qohwxv/Transformer/01_SOURCE_CODE_DAY_DU/immutable/board_candidate_pause_checkpoint/PAYLOAD_INVENTORY.txt

PAYLOAD_SHA256SUMS.txt 9361
artifacts/OUTPUT_SHA256SUMS 10071
artifacts/RUN_STATUS.txt 1326
artifacts/vit_system_wrapper.bit 7797814
artifacts/vit_system_wrapper.xsa 3855492
board/m8_v3_mode3_50mhz.identity 5263
board/tools/README.md 9257
board/tools/analyze_m8_capture.py 14602
board/tools/build_m8_genesys_fsbl.tcl 6184
board/tools/compare_m8_outputs.py 8145
board/tools/m8_board_identity.py 37742
board/tools/replay_m8_board.tcl 35183
board/tools/run_m8_board.sh 12286
board/tools/test_m8_board_tools.py 11984
metadata/00_verify_m8_development.sh 33153
metadata/BUNDLE_INFO.json 59642
metadata/M8_DEVELOPMENT_SHA256SUMS.txt 44326
metadata/PERF_PROFILE_ABI_V1_13.json 8312
model/hash_manifest.json 1136
model/post_encoder_step_32_logits_f32.hex 9000
model/post_encoder_step_33p_probabilities_f32.hex 9000
model/prepared_input.bin 602112
model/verification_report.json 232013
model/vit_model.bin 173685760
model/vit_model_table.bin 12928
model/vit_model_table.json 236235
model/vit_runtime_config.json 7854
receipt/FULL_VIVADO_RECEIPT_README.md 4794
receipt/FULL_VIVADO_RECEIPT_STATUS.json 4530
receipt/RECEIPT_MANIFEST.sha256 89
receipt/verify_receipt.sh 12317
reports/board_post_route_constraint_coverage_gate.rpt 4806
reports/board_post_route_drc_gate.rpt 57
reports/board_post_route_dsp.rpt 31
reports/board_post_route_m8_ram_mapping.rpt 364582
reports/board_post_route_methodology_gate.rpt 65
reports/board_post_route_route_gate.rpt 34
reports/board_post_route_timing_gate.rpt 31
reports/board_post_route_utilization.rpt 13127
reports/board_post_route_xsa_contents.rpt 515
simulation/interrupted_layer0_receipt/INTERRUPTION_METADATA.txt 1080
simulation/interrupted_layer0_receipt/MARKER_AUDIT.txt 189
simulation/interrupted_layer0_receipt/PAYLOAD_SHA256SUMS.txt 3930
simulation/interrupted_layer0_receipt/PROCESS_STATE_AT_CAPTURE.txt 154
simulation/interrupted_layer0_receipt/REMOTE_RESOURCE_STATE.txt 161
simulation/interrupted_layer0_receipt/SOURCE_INPUT_PATHS.txt 4410
simulation/interrupted_layer0_receipt/SOURCE_STATE_BEFORE_ORIGINAL.txt 1506
simulation/interrupted_layer0_receipt/SOURCE_STATE_CURRENT_SHA256SUMS.txt 11010
simulation/interrupted_layer0_receipt/SOURCE_STATE_CURRENT_SUMMARY.txt 217
simulation/interrupted_layer0_receipt/outer/m8-e02-layer0-reqfix-cb31a804-20260809T030500Z.outer.exit 2
simulation/interrupted_layer0_receipt/outer/m8-e02-layer0-reqfix-cb31a804-20260809T030500Z.outer.log 27338
simulation/interrupted_layer0_receipt/outer/m8-e02-layer0-reqfix-cb31a804-20260809T030500Z.outer.pid 8
simulation/interrupted_layer0_receipt/run/SOURCE_STATE_BEFORE.txt 1506
simulation/interrupted_layer0_receipt/run/build.log 21026
simulation/interrupted_layer0_receipt/run/layers/layer00/asset_stage.log 401
simulation/interrupted_layer0_receipt/run/layers/layer00/assets/asset_evidence.json 15621
simulation/interrupted_layer0_receipt/run/layers/layer00/assets/fc1_bias_f32.hex 27648
simulation/interrupted_layer0_receipt/run/layers/layer00/assets/fc1_weight_packed_fp16_u32.hex 10616832
simulation/interrupted_layer0_receipt/run/layers/layer00/assets/fc2_bias_f32.hex 6912
simulation/interrupted_layer0_receipt/run/layers/layer00/assets/fc2_weight_packed_fp16_u32.hex 10616832
simulation/interrupted_layer0_receipt/run/layers/layer00/assets/golden_t004_f32.hex 1361664
simulation/interrupted_layer0_receipt/run/layers/layer00/assets/input_t004_f32.hex 1361664
simulation/interrupted_layer0_receipt/run/layers/layer00/assets/k_bias_f32.hex 6912
simulation/interrupted_layer0_receipt/run/layers/layer00/assets/k_weight_packed_fp16_u32.hex 2654208
simulation/interrupted_layer0_receipt/run/layers/layer00/assets/ln1_beta_f32.hex 6912
simulation/interrupted_layer0_receipt/run/layers/layer00/assets/ln1_gamma_f32.hex 6912
simulation/interrupted_layer0_receipt/run/layers/layer00/assets/ln2_beta_f32.hex 6912
simulation/interrupted_layer0_receipt/run/layers/layer00/assets/ln2_gamma_f32.hex 6912
simulation/interrupted_layer0_receipt/run/layers/layer00/assets/o_bias_f32.hex 6912
simulation/interrupted_layer0_receipt/run/layers/layer00/assets/o_weight_packed_fp16_u32.hex 2654208
simulation/interrupted_layer0_receipt/run/layers/layer00/assets/q_bias_f32.hex 6912
simulation/interrupted_layer0_receipt/run/layers/layer00/assets/q_weight_packed_fp16_u32.hex 2654208
simulation/interrupted_layer0_receipt/run/layers/layer00/assets/v_bias_f32.hex 6912
simulation/interrupted_layer0_receipt/run/layers/layer00/assets/v_weight_packed_fp16_u32.hex 2654208
simulation/interrupted_layer0_receipt/run/layers/layer00/outputs/encoder_output_rtl_f32.hex 0
simulation/interrupted_layer0_receipt/run/layers/layer00/run.log 4094
simulation/interrupted_layer0_receipt/run/summary.log 27153
source/SOURCE_SNAPSHOT.tar.gz 140007
