qohwxv/Transformer/01_SOURCE_CODE_DAY_DU/immutable/full_vivado_receipt/remote_snapshot/reports/m8/server_runs/20260808T181104Z-m8-e01-mode3-threepass-receipt/TRANSFER_VERIFICATION.txt

REMOTE_TO_LOCAL_TRANSFER VERIFIED
evidence_class=VERIFIED
captured_utc=2026-08-08T18:14:38Z
method=rsync_archive_copy_then_checksum_itemized_dry_run
remote_host=192.168.4.85
remote_workspace=/home/s23520579/Vivado_project/vit_m8_db4e84bbe7b2_workspace
raw_run_20260808T172200Z_files=2 checksum_differences=0
raw_run_20260808T172400Z_files=20 checksum_differences=0
raw_run_20260808T173900Z_files=20 checksum_differences=0
raw_run_20260808T175400Z_files=20 checksum_differences=0
production_workspace_paths=80 checksum_differences=0
explicit_workspace_input_paths=18 checksum_differences=0
workspace_snapshot_unique_files=98
rsync_checksum_dry_run_stdout_lines=0
current_runner_remote_sha256=0f376c03632d9fa5148b1939004d992ebecf4b88e71cd977ff0573b1c1ab98f6
current_runner_local_sha256=0f376c03632d9fa5148b1939004d992ebecf4b88e71cd977ff0573b1c1ab98f6
current_runner_remote_local_match=YES
historical_observation_runner_origin=/tmp/m8_e01_observation_runner_1a12cdc9.sh
historical_exact_repeat_runner_origin=/tmp/m8_e01_repeat_runner_5a4c39e5.sh
historical_runner_identity_binding=recorded_source_state_sha256_and_exact_local_sha256
remote_mutation=NONE
