qohwxv/Transformer/01_SOURCE_CODE_DAY_DU/immutable/full_vivado_receipt/remote_snapshot/reports/m8/server_runs/20260808T161943Z-m8-softmax-ooc-ab-holdfix/VERIFICATION_RESULT.txt

VERIFIED_UTC=2026-08-08T16:37:18Z
RESULT=PASS
STATUS=SAFE
REMOTE_RUN_FILES=38
REMOTE_LOCAL_RUN_HASH_SET_MATCH=PASS
REMOTE_INITIAL_FAILURE_FILES=31
REMOTE_LOCAL_INITIAL_FAILURE_HASH_SET_MATCH=PASS
PASS_INPUT_FILES=13
PASS_INPUT_SHA256_CHECK=PASS
SOURCE_IDENTITY_VERIFY=PASS
PARENT_TERMINAL_GATES=PASS
CANDIDATE_TERMINAL_GATES=PASS
PARENT_DSP48_DSP58=0
CANDIDATE_DSP48_DSP58=0
CANDIDATE_RAMB36E2=1
INITIAL_FAILURE_PAYLOAD_SHA256_CHECK=PASS
REMOTE_MUTATION=NONE
FULL_DESIGN_RESULT=UNVERIFIED
BOARD_RESULT=UNVERIFIED
