qohwxv/Transformer/01_SOURCE_CODE_DAY_DU/immutable/full_vivado_receipt/remote_snapshot/reports/m8/server_runs/20260808T171800Z-m8-xsim-exact-10of10-receipt/TRANSFER_VERIFICATION.txt

Date: 2026-08-08 UTC
Method: rsync checksum-only dry-run after local copy; server side read-only
REMOTE_LOCAL_CHECKSUM_PARITY_PASS raw_runs=6 production_sources=80 xsim_inputs=11

The six remote run directories produced no checksum, size, path, or deletion
difference. The 80 production sources and all 11 filelist/runner/test/model
input paths also produced no checksum difference.
