qohwxv/Transformer/ILSVRC2012_dataset_test/inference_results_1000.csv

Image_Index | Image_Name | Expected_Class_ID | Expected_Class_Name | Predicted_Class_ID | Predicted_Class_Name | Top1_Match | Top5_Match | Latency_ms
1 | ILSVRC2012_val_00000001.JPEG | 65 | sea_snake | 65 | sea_snake | True | True | 168.02
2 | ILSVRC2012_val_00000002.JPEG | 970 | alp | 795 | ski | False | True | 172.57
3 | ILSVRC2012_val_00000003.JPEG | 230 | Shetland_sheepdog | 230 | Shetland_sheepdog | True | True | 180.33
4 | ILSVRC2012_val_00000004.JPEG | 809 | soup_bowl | 809 | soup_bowl | True | True | 178.37
5 | ILSVRC2012_val_00000005.JPEG | 516 | cradle | 520 | crib | False | True | 177.13
6 | ILSVRC2012_val_00000006.JPEG | 57 | garter_snake | 60 | night_snake | False | True | 187.81
7 | ILSVRC2012_val_00000007.JPEG | 334 | porcupine | 334 | porcupine | True | True | 175.34
8 | ILSVRC2012_val_00000008.JPEG | 415 | bakery | 415 | bakery | True | True | 183.46
9 | ILSVRC2012_val_00000009.JPEG | 674 | mousetrap | 674 | mousetrap | True | True | 175.79
10 | ILSVRC2012_val_00000010.JPEG | 332 | Angora | 332 | Angora | True | True | 179.12
11 | ILSVRC2012_val_00000011.JPEG | 109 | brain_coral | 109 | brain_coral | True | True | 177.51
12 | ILSVRC2012_val_00000012.JPEG | 286 | cougar | 286 | cougar | True | True | 175.57
13 | ILSVRC2012_val_00000013.JPEG | 370 | guenon | 370 | guenon | True | True | 179.91
14 | ILSVRC2012_val_00000014.JPEG | 757 | recreational_vehicle | 757 | recreational_vehicle | True | True | 180.74
15 | ILSVRC2012_val_00000015.JPEG | 595 | harvester | 595 | harvester | True | True | 179.40
16 | ILSVRC2012_val_00000016.JPEG | 147 | grey_whale | 147 | grey_whale | True | True | 178.61
17 | ILSVRC2012_val_00000017.JPEG | 108 | sea_anemone | 108 | sea_anemone | True | True | 177.63
18 | ILSVRC2012_val_00000018.JPEG | 23 | vulture | 23 | vulture | True | True | 180.18
19 | ILSVRC2012_val_00000019.JPEG | 478 | carton | 478 | carton | True | True | 184.34
20 | ILSVRC2012_val_00000020.JPEG | 517 | crane | 517 | crane | True | True | 179.89
21 | ILSVRC2012_val_00000021.JPEG | 334 | porcupine | 334 | porcupine | True | True | 183.48
22 | ILSVRC2012_val_00000022.JPEG | 173 | Ibizan_hound | 238 | Greater_Swiss_Mountain_dog | False | True | 184.89
23 | ILSVRC2012_val_00000023.JPEG | 948 | Granny_Smith | 948 | Granny_Smith | True | True | 180.93
24 | ILSVRC2012_val_00000024.JPEG | 727 | planetarium | 727 | planetarium | True | True | 183.33
25 | ILSVRC2012_val_00000025.JPEG | 23 | vulture | 23 | vulture | True | True | 186.89
26 | ILSVRC2012_val_00000026.JPEG | 846 | table_lamp | 846 | table_lamp | True | True | 186.26
27 | ILSVRC2012_val_00000027.JPEG | 270 | white_wolf | 270 | white_wolf | True | True | 186.30
28 | ILSVRC2012_val_00000028.JPEG | 167 | English_foxhound | 166 | Walker_hound | False | True | 186.32
29 | ILSVRC2012_val_00000029.JPEG | 55 | green_snake | 55 | green_snake | True | True | 184.97
30 | ILSVRC2012_val_00000030.JPEG | 858 | tile_roof | 858 | tile_roof | True | True | 186.02
31 | ILSVRC2012_val_00000031.JPEG | 324 | cabbage_butterfly | 324 | cabbage_butterfly | True | True | 188.98
32 | ILSVRC2012_val_00000032.JPEG | 573 | go-kart | 573 | go-kart | True | True | 189.54
33 | ILSVRC2012_val_00000033.JPEG | 150 | sea_lion | 150 | sea_lion | True | True | 187.31
34 | ILSVRC2012_val_00000034.JPEG | 981 | ballplayer | 981 | ballplayer | True | True | 190.82
35 | ILSVRC2012_val_00000035.JPEG | 586 | half_track | 586 | half_track | True | True | 191.71
36 | ILSVRC2012_val_00000036.JPEG | 887 | vestment | 887 | vestment | True | True | 197.50
37 | ILSVRC2012_val_00000037.JPEG | 32 | tailed_frog | 26 | common_newt | False | True | 192.38
38 | ILSVRC2012_val_00000038.JPEG | 398 | abacus | 398 | abacus | True | True | 192.54
39 | ILSVRC2012_val_00000039.JPEG | 777 | scabbard | 777 | scabbard | True | True | 195.36
40 | ILSVRC2012_val_00000040.JPEG | 74 | garden_spider | 74 | garden_spider | True | True | 191.98
41 | ILSVRC2012_val_00000041.JPEG | 516 | cradle | 431 | bassinet | False | True | 194.61
42 | ILSVRC2012_val_00000042.JPEG | 756 | rain_barrel | 756 | rain_barrel | True | True | 192.22
43 | ILSVRC2012_val_00000043.JPEG | 129 | spoonbill | 129 | spoonbill | True | True | 193.32
44 | ILSVRC2012_val_00000044.JPEG | 198 | standard_schnauzer | 198 | standard_schnauzer | True | True | 194.34
45 | ILSVRC2012_val_00000045.JPEG | 256 | Newfoundland | 256 | Newfoundland | True | True | 197.36
46 | ILSVRC2012_val_00000046.JPEG | 725 | pitcher | 725 | pitcher | True | True | 199.48
47 | ILSVRC2012_val_00000047.JPEG | 565 | freight_car | 565 | freight_car | True | True | 196.48
48 | ILSVRC2012_val_00000048.JPEG | 167 | English_foxhound | 166 | Walker_hound | False | True | 212.59
49 | ILSVRC2012_val_00000049.JPEG | 717 | pickup | 717 | pickup | True | True | 195.08
50 | ILSVRC2012_val_00000050.JPEG | 394 | sturgeon | 390 | eel | False | True | 200.02
51 | ILSVRC2012_val_00000051.JPEG | 92 | bee_eater | 92 | bee_eater | True | True | 198.01
52 | ILSVRC2012_val_00000052.JPEG | 29 | axolotl | 29 | axolotl | True | True | 198.98
53 | ILSVRC2012_val_00000053.JPEG | 844 | switch | 844 | switch | True | True | 199.04
54 | ILSVRC2012_val_00000054.JPEG | 591 | handkerchief | 591 | handkerchief | True | True | 208.43
55 | ILSVRC2012_val_00000055.JPEG | 358 | polecat | 358 | polecat | True | True | 204.65
56 | ILSVRC2012_val_00000056.JPEG | 468 | cab | 468 | cab | True | True | 219.43
57 | ILSVRC2012_val_00000057.JPEG | 259 | Pomeranian | 154 | Pekinese | False | True | 200.42
58 | ILSVRC2012_val_00000058.JPEG | 994 | stinkhorn | 994 | stinkhorn | True | True | 199.72
59 | ILSVRC2012_val_00000059.JPEG | 872 | tripod | 872 | tripod | True | True | 207.60
60 | ILSVRC2012_val_00000060.JPEG | 588 | hamper | 588 | hamper | True | True | 208.63
61 | ILSVRC2012_val_00000061.JPEG | 474 | cardigan | 474 | cardigan | True | True | 198.53
62 | ILSVRC2012_val_00000062.JPEG | 183 | Kerry_blue_terrier | 183 | Kerry_blue_terrier | True | True | 209.75
63 | ILSVRC2012_val_00000063.JPEG | 107 | jellyfish | 107 | jellyfish | True | True | 206.20
64 | ILSVRC2012_val_00000064.JPEG | 46 | green_lizard | 46 | green_lizard | True | True | 219.48
65 | ILSVRC2012_val_00000065.JPEG | 842 | swimming_trunks | 842 | swimming_trunks | True | True | 203.56
66 | ILSVRC2012_val_00000066.JPEG | 390 | eel | 390 | eel | True | True | 201.03
67 | ILSVRC2012_val_00000067.JPEG | 101 | tusker | 101 | tusker | True | True | 201.14
68 | ILSVRC2012_val_00000068.JPEG | 887 | vestment | 887 | vestment | True | True | 201.45
69 | ILSVRC2012_val_00000069.JPEG | 870 | tricycle | 870 | tricycle | True | True | 204.33
70 | ILSVRC2012_val_00000070.JPEG | 841 | sweatshirt | 735 | poncho | False | True | 201.50
71 | ILSVRC2012_val_00000071.JPEG | 467 | butcher_shop | 467 | butcher_shop | True | True | 203.68
72 | ILSVRC2012_val_00000072.JPEG | 149 | dugong | 149 | dugong | True | True | 203.51
73 | ILSVRC2012_val_00000073.JPEG | 21 | kite | 21 | kite | True | True | 206.24
74 | ILSVRC2012_val_00000074.JPEG | 476 | carousel | 476 | carousel | True | True | 207.01
75 | ILSVRC2012_val_00000075.JPEG | 80 | black_grouse | 80 | black_grouse | True | True | 208.38
76 | ILSVRC2012_val_00000076.JPEG | 424 | barbershop | 424 | barbershop | True | True | 210.12
77 | ILSVRC2012_val_00000077.JPEG | 159 | Rhodesian_ridgeback | 159 | Rhodesian_ridgeback | True | True | 208.42
78 | ILSVRC2012_val_00000078.JPEG | 275 | African_hunting_dog | 275 | African_hunting_dog | True | True | 323.65
79 | ILSVRC2012_val_00000079.JPEG | 175 | otterhound | 175 | otterhound | True | True | 289.63
80 | ILSVRC2012_val_00000080.JPEG | 461 | breastplate | 461 | breastplate | True | True | 303.09
81 | ILSVRC2012_val_00000081.JPEG | 970 | alp | 970 | alp | True | True | 290.02
82 | ILSVRC2012_val_00000082.JPEG | 160 | Afghan_hound | 160 | Afghan_hound | True | True | 316.87
83 | ILSVRC2012_val_00000083.JPEG | 788 | shoe_shop | 788 | shoe_shop | True | True | 302.03
84 | ILSVRC2012_val_00000084.JPEG | 58 | water_snake | 58 | water_snake | True | True | 466.79
85 | ILSVRC2012_val_00000085.JPEG | 479 | car_wheel | 479 | car_wheel | True | True | 293.99
86 | ILSVRC2012_val_00000086.JPEG | 498 | cinema | 498 | cinema | True | True | 325.22
87 | ILSVRC2012_val_00000087.JPEG | 369 | siamang | 380 | titi | False | False | 302.28
88 | ILSVRC2012_val_00000088.JPEG | 28 | spotted_salamander | 28 | spotted_salamander | True | True | 291.68
89 | ILSVRC2012_val_00000089.JPEG | 487 | cellular_telephone | 487 | cellular_telephone | True | True | 299.86
90 | ILSVRC2012_val_00000090.JPEG | 50 | American_alligator | 50 | American_alligator | True | True | 276.13
91 | ILSVRC2012_val_00000091.JPEG | 270 | white_wolf | 270 | white_wolf | True | True | 284.87
92 | ILSVRC2012_val_00000092.JPEG | 383 | Madagascar_cat | 384 | indri | False | True | 273.91
93 | ILSVRC2012_val_00000093.JPEG | 366 | gorilla | 366 | gorilla | True | True | 283.38
94 | ILSVRC2012_val_00000094.JPEG | 780 | schooner | 484 | catamaran | False | True | 277.42
95 | ILSVRC2012_val_00000095.JPEG | 373 | macaque | 373 | macaque | True | True | 280.81
96 | ILSVRC2012_val_00000096.JPEG | 705 | passenger_car | 705 | passenger_car | True | True | 290.85
97 | ILSVRC2012_val_00000097.JPEG | 330 | wood_rabbit | 330 | wood_rabbit | True | True | 275.35
98 | ILSVRC2012_val_00000098.JPEG | 142 | dowitcher | 142 | dowitcher | True | True | 293.35
99 | ILSVRC2012_val_00000099.JPEG | 949 | strawberry | 949 | strawberry | True | True | 276.21
100 | ILSVRC2012_val_00000100.JPEG | 349 | bighorn | 349 | bighorn | True | True | 295.62
101 | ILSVRC2012_val_00000101.JPEG | 473 | can_opener | 473 | can_opener | True | True | 311.46
102 | ILSVRC2012_val_00000102.JPEG | 159 | Rhodesian_ridgeback | 159 | Rhodesian_ridgeback | True | True | 286.40
103 | ILSVRC2012_val_00000103.JPEG | 872 | tripod | 872 | tripod | True | True | 284.87
104 | ILSVRC2012_val_00000104.JPEG | 878 | typewriter_keyboard | 878 | typewriter_keyboard | True | True | 304.32
105 | ILSVRC2012_val_00000105.JPEG | 201 | silky_terrier | 201 | silky_terrier | True | True | 291.46
106 | ILSVRC2012_val_00000106.JPEG | 906 | Windsor_tie | 906 | Windsor_tie | True | True | 296.83
107 | ILSVRC2012_val_00000107.JPEG | 70 | harvestman | 70 | harvestman | True | True | 307.57
108 | ILSVRC2012_val_00000108.JPEG | 486 | cello | 486 | cello | True | True | 290.98
109 | ILSVRC2012_val_00000109.JPEG | 632 | loudspeaker | 632 | loudspeaker | True | True | 283.17
110 | ILSVRC2012_val_00000110.JPEG | 608 | jean | 608 | jean | True | True | 295.29
111 | ILSVRC2012_val_00000111.JPEG | 122 | American_lobster | 122 | American_lobster | True | True | 280.11
112 | ILSVRC2012_val_00000112.JPEG | 720 | pill_bottle | 720 | pill_bottle | True | True | 285.08
113 | ILSVRC2012_val_00000113.JPEG | 227 | kelpie | 227 | kelpie | True | True | 468.55
114 | ILSVRC2012_val_00000114.JPEG | 686 | oil_filter | 686 | oil_filter | True | True | 294.99
115 | ILSVRC2012_val_00000115.JPEG | 173 | Ibizan_hound | 173 | Ibizan_hound | True | True | 294.19
116 | ILSVRC2012_val_00000116.JPEG | 959 | carbonara | 959 | carbonara | True | True | 297.62
117 | ILSVRC2012_val_00000117.JPEG | 638 | maillot | 638 | maillot | True | True | 299.03
118 | ILSVRC2012_val_00000118.JPEG | 646 | maze | 646 | maze | True | True | 296.31
119 | ILSVRC2012_val_00000119.JPEG | 664 | monitor | 598 | home_theater | False | True | 292.40
120 | ILSVRC2012_val_00000120.JPEG | 645 | maypole | 645 | maypole | True | True | 280.58
121 | ILSVRC2012_val_00000121.JPEG | 718 | pier | 449 | boathouse | False | True | 284.04
122 | ILSVRC2012_val_00000122.JPEG | 483 | castle | 483 | castle | True | True | 281.40
123 | ILSVRC2012_val_00000123.JPEG | 852 | tennis_ball | 852 | tennis_ball | True | True | 292.31
124 | ILSVRC2012_val_00000124.JPEG | 392 | rock_beauty | 397 | puffer | False | True | 301.02
125 | ILSVRC2012_val_00000125.JPEG | 311 | grasshopper | 311 | grasshopper | True | True | 295.98
126 | ILSVRC2012_val_00000126.JPEG | 457 | bow_tie | 457 | bow_tie | True | True | 308.27
127 | ILSVRC2012_val_00000127.JPEG | 352 | impala | 352 | impala | True | True | 286.46
128 | ILSVRC2012_val_00000128.JPEG | 22 | bald_eagle | 21 | kite | False | True | 292.79
129 | ILSVRC2012_val_00000129.JPEG | 934 | hotdog | 934 | hotdog | True | True | 294.44
130 | ILSVRC2012_val_00000130.JPEG | 283 | Persian_cat | 283 | Persian_cat | True | True | 296.67
131 | ILSVRC2012_val_00000131.JPEG | 802 | snowmobile | 802 | snowmobile | True | True | 299.29
132 | ILSVRC2012_val_00000132.JPEG | 553 | file | 553 | file | True | True | 288.17
133 | ILSVRC2012_val_00000133.JPEG | 276 | hyena | 276 | hyena | True | True | 289.05
134 | ILSVRC2012_val_00000134.JPEG | 236 | Doberman | 234 | Rottweiler | False | True | 297.74
135 | ILSVRC2012_val_00000135.JPEG | 751 | racer | 751 | racer | True | True | 293.88
136 | ILSVRC2012_val_00000136.JPEG | 343 | warthog | 342 | wild_boar | False | True | 312.21
137 | ILSVRC2012_val_00000137.JPEG | 528 | dial_telephone | 613 | joystick | False | True | 308.98
138 | ILSVRC2012_val_00000138.JPEG | 328 | sea_urchin | 328 | sea_urchin | True | True | 323.99
139 | ILSVRC2012_val_00000139.JPEG | 969 | eggnog | 969 | eggnog | True | True | 297.70
140 | ILSVRC2012_val_00000140.JPEG | 558 | flute | 251 | dalmatian | False | True | 296.63
141 | ILSVRC2012_val_00000141.JPEG | 163 | bloodhound | 163 | bloodhound | True | True | 461.22
142 | ILSVRC2012_val_00000142.JPEG | 328 | sea_urchin | 328 | sea_urchin | True | True | 281.46
143 | ILSVRC2012_val_00000143.JPEG | 771 | safe | 771 | safe | True | True | 307.61
144 | ILSVRC2012_val_00000144.JPEG | 726 | plane | 726 | plane | True | True | 350.83
145 | ILSVRC2012_val_00000145.JPEG | 977 | sandbar | 977 | sandbar | True | True | 356.79
146 | ILSVRC2012_val_00000146.JPEG | 875 | trombone | 513 | cornet | False | True | 326.49
147 | ILSVRC2012_val_00000147.JPEG | 265 | toy_poodle | 266 | miniature_poodle | False | True | 316.63
148 | ILSVRC2012_val_00000148.JPEG | 686 | oil_filter | 686 | oil_filter | True | True | 297.86
149 | ILSVRC2012_val_00000149.JPEG | 590 | hand-held_computer | 590 | hand-held_computer | True | True | 291.74
150 | ILSVRC2012_val_00000150.JPEG | 975 | lakeside | 978 | seashore | False | True | 288.61
151 | ILSVRC2012_val_00000151.JPEG | 620 | laptop | 681 | notebook | False | True | 300.67
152 | ILSVRC2012_val_00000152.JPEG | 637 | mailbox | 637 | mailbox | True | True | 348.50
153 | ILSVRC2012_val_00000153.JPEG | 39 | common_iguana | 39 | common_iguana | True | True | 324.04
154 | ILSVRC2012_val_00000154.JPEG | 115 | sea_slug | 115 | sea_slug | True | True | 307.85
155 | ILSVRC2012_val_00000155.JPEG | 937 | broccoli | 937 | broccoli | True | True | 305.63
156 | ILSVRC2012_val_00000156.JPEG | 272 | coyote | 274 | dhole | False | False | 297.22
157 | ILSVRC2012_val_00000157.JPEG | 277 | red_fox | 277 | red_fox | True | True | 300.02
158 | ILSVRC2012_val_00000158.JPEG | 763 | revolver | 763 | revolver | True | True | 291.24
159 | ILSVRC2012_val_00000159.JPEG | 789 | shoji | 532 | dining_table | False | False | 303.44
160 | ILSVRC2012_val_00000160.JPEG | 646 | maze | 646 | maze | True | True | 300.07
161 | ILSVRC2012_val_00000161.JPEG | 213 | Irish_setter | 168 | redbone | False | True | 308.29
162 | ILSVRC2012_val_00000162.JPEG | 493 | chiffonier | 894 | wardrobe | False | True | 293.06
163 | ILSVRC2012_val_00000163.JPEG | 647 | measuring_cup | 647 | measuring_cup | True | True | 301.24
164 | ILSVRC2012_val_00000164.JPEG | 504 | coffee_mug | 504 | coffee_mug | True | True | 290.82
165 | ILSVRC2012_val_00000165.JPEG | 937 | broccoli | 937 | broccoli | True | True | 293.86
166 | ILSVRC2012_val_00000166.JPEG | 687 | organ | 687 | organ | True | True | 296.03
167 | ILSVRC2012_val_00000167.JPEG | 781 | scoreboard | 781 | scoreboard | True | True | 298.79
168 | ILSVRC2012_val_00000168.JPEG | 666 | mortar | 666 | mortar | True | True | 289.75
169 | ILSVRC2012_val_00000169.JPEG | 583 | guillotine | 583 | guillotine | True | True | 551.03
170 | ILSVRC2012_val_00000170.JPEG | 158 | toy_terrier | 158 | toy_terrier | True | True | 291.05
171 | ILSVRC2012_val_00000171.JPEG | 825 | stone_wall | 825 | stone_wall | True | True | 302.07
172 | ILSVRC2012_val_00000172.JPEG | 212 | English_setter | 212 | English_setter | True | True | 294.71
173 | ILSVRC2012_val_00000173.JPEG | 659 | mixing_bowl | 659 | mixing_bowl | True | True | 308.45
174 | ILSVRC2012_val_00000174.JPEG | 257 | Great_Pyrenees | 257 | Great_Pyrenees | True | True | 290.27
175 | ILSVRC2012_val_00000175.JPEG | 436 | beach_wagon | 436 | beach_wagon | True | True | 296.10
176 | ILSVRC2012_val_00000176.JPEG | 196 | miniature_schnauzer | 199 | Scotch_terrier | False | False | 299.29
177 | ILSVRC2012_val_00000177.JPEG | 140 | red-backed_sandpiper | 140 | red-backed_sandpiper | True | True | 288.79
178 | ILSVRC2012_val_00000178.JPEG | 248 | Eskimo_dog | 250 | Siberian_husky | False | True | 288.29
179 | ILSVRC2012_val_00000179.JPEG | 339 | sorrel | 339 | sorrel | True | True | 305.88
180 | ILSVRC2012_val_00000180.JPEG | 230 | Shetland_sheepdog | 230 | Shetland_sheepdog | True | True | 300.46
181 | ILSVRC2012_val_00000181.JPEG | 361 | skunk | 361 | skunk | True | True | 301.69
182 | ILSVRC2012_val_00000182.JPEG | 544 | Dutch_oven | 926 | hot_pot | False | True | 291.33
183 | ILSVRC2012_val_00000183.JPEG | 935 | mashed_potato | 935 | mashed_potato | True | True | 297.35
184 | ILSVRC2012_val_00000184.JPEG | 638 | maillot | 445 | bikini | False | True | 302.76
185 | ILSVRC2012_val_00000185.JPEG | 627 | limousine | 656 | minivan | False | True | 311.87
186 | ILSVRC2012_val_00000186.JPEG | 289 | snow_leopard | 289 | snow_leopard | True | True | 291.01
187 | ILSVRC2012_val_00000187.JPEG | 867 | trailer_truck | 867 | trailer_truck | True | True | 308.62
188 | ILSVRC2012_val_00000188.JPEG | 272 | coyote | 272 | coyote | True | True | 323.87
189 | ILSVRC2012_val_00000189.JPEG | 103 | platypus | 103 | platypus | True | True | 306.39
190 | ILSVRC2012_val_00000190.JPEG | 584 | hair_slide | 584 | hair_slide | True | True | 286.59
191 | ILSVRC2012_val_00000191.JPEG | 180 | American_Staffordshire_terrier | 180 | American_Staffordshire_terrier | True | True | 286.32
192 | ILSVRC2012_val_00000192.JPEG | 703 | park_bench | 703 | park_bench | True | True | 304.33
193 | ILSVRC2012_val_00000193.JPEG | 449 | boathouse | 449 | boathouse | True | True | 300.70
194 | ILSVRC2012_val_00000194.JPEG | 771 | safe | 771 | safe | True | True | 294.75
195 | ILSVRC2012_val_00000195.JPEG | 118 | Dungeness_crab | 118 | Dungeness_crab | True | True | 291.36
196 | ILSVRC2012_val_00000196.JPEG | 396 | lionfish | 396 | lionfish | True | True | 298.92
197 | ILSVRC2012_val_00000197.JPEG | 934 | hotdog | 934 | hotdog | True | True | 297.60
198 | ILSVRC2012_val_00000198.JPEG | 16 | bulbul | 16 | bulbul | True | True | 293.60
199 | ILSVRC2012_val_00000199.JPEG | 548 | entertainment_center | 548 | entertainment_center | True | True | 468.65
200 | ILSVRC2012_val_00000200.JPEG | 993 | gyromitra | 993 | gyromitra | True | True | 307.67
201 | ILSVRC2012_val_00000201.JPEG | 704 | parking_meter | 704 | parking_meter | True | True | 324.30
202 | ILSVRC2012_val_00000202.JPEG | 457 | bow_tie | 452 | bonnet | False | True | 295.08
203 | ILSVRC2012_val_00000203.JPEG | 233 | Bouvier_des_Flandres | 233 | Bouvier_des_Flandres | True | True | 307.33
204 | ILSVRC2012_val_00000204.JPEG | 401 | accordion | 642 | marimba | False | True | 295.06
205 | ILSVRC2012_val_00000205.JPEG | 827 | stove | 827 | stove | True | True | 303.22
206 | ILSVRC2012_val_00000206.JPEG | 376 | proboscis_monkey | 376 | proboscis_monkey | True | True | 292.12
207 | ILSVRC2012_val_00000207.JPEG | 146 | albatross | 146 | albatross | True | True | 293.95
208 | ILSVRC2012_val_00000208.JPEG | 606 | iron | 606 | iron | True | True | 311.58
209 | ILSVRC2012_val_00000209.JPEG | 922 | menu | 922 | menu | True | True | 318.45
210 | ILSVRC2012_val_00000210.JPEG | 516 | cradle | 431 | bassinet | False | True | 305.91
211 | ILSVRC2012_val_00000211.JPEG | 284 | Siamese_cat | 284 | Siamese_cat | True | True | 300.60
212 | ILSVRC2012_val_00000212.JPEG | 889 | violin | 889 | violin | True | True | 289.23
213 | ILSVRC2012_val_00000213.JPEG | 475 | car_mirror | 475 | car_mirror | True | True | 306.77
214 | ILSVRC2012_val_00000214.JPEG | 978 | seashore | 978 | seashore | True | True | 286.33
215 | ILSVRC2012_val_00000215.JPEG | 475 | car_mirror | 475 | car_mirror | True | True | 295.41
216 | ILSVRC2012_val_00000216.JPEG | 984 | rapeseed | 984 | rapeseed | True | True | 300.17
217 | ILSVRC2012_val_00000217.JPEG | 16 | bulbul | 16 | bulbul | True | True | 303.74
218 | ILSVRC2012_val_00000218.JPEG | 77 | wolf_spider | 77 | wolf_spider | True | True | 296.49
219 | ILSVRC2012_val_00000219.JPEG | 610 | jersey | 610 | jersey | True | True | 310.54
220 | ILSVRC2012_val_00000220.JPEG | 254 | pug | 254 | pug | True | True | 314.65
221 | ILSVRC2012_val_00000221.JPEG | 636 | mailbag | 636 | mailbag | True | True | 295.73
222 | ILSVRC2012_val_00000222.JPEG | 662 | modem | 662 | modem | True | True | 288.69
223 | ILSVRC2012_val_00000223.JPEG | 473 | can_opener | 473 | can_opener | True | True | 314.24
224 | ILSVRC2012_val_00000224.JPEG | 213 | Irish_setter | 213 | Irish_setter | True | True | 306.52
225 | ILSVRC2012_val_00000225.JPEG | 25 | European_fire_salamander | 25 | European_fire_salamander | True | True | 302.59
226 | ILSVRC2012_val_00000226.JPEG | 463 | bucket | 463 | bucket | True | True | 297.15
227 | ILSVRC2012_val_00000227.JPEG | 215 | Brittany_spaniel | 215 | Brittany_spaniel | True | True | 296.19
228 | ILSVRC2012_val_00000228.JPEG | 173 | Ibizan_hound | 173 | Ibizan_hound | True | True | 288.66
229 | ILSVRC2012_val_00000229.JPEG | 35 | mud_turtle | 35 | mud_turtle | True | True | 466.17
230 | ILSVRC2012_val_00000230.JPEG | 741 | prayer_rug | 741 | prayer_rug | True | True | 337.70
231 | ILSVRC2012_val_00000231.JPEG | 125 | hermit_crab | 125 | hermit_crab | True | True | 352.10
232 | ILSVRC2012_val_00000232.JPEG | 787 | shield | 399 | abaya | False | False | 246.38
233 | ILSVRC2012_val_00000233.JPEG | 289 | snow_leopard | 289 | snow_leopard | True | True | 220.83
234 | ILSVRC2012_val_00000234.JPEG | 425 | barn | 425 | barn | True | True | 222.84
235 | ILSVRC2012_val_00000235.JPEG | 973 | coral_reef | 973 | coral_reef | True | True | 217.69
236 | ILSVRC2012_val_00000236.JPEG | 1 | goldfish | 1 | goldfish | True | True | 221.91
237 | ILSVRC2012_val_00000237.JPEG | 167 | English_foxhound | 167 | English_foxhound | True | True | 218.48
238 | ILSVRC2012_val_00000238.JPEG | 121 | king_crab | 121 | king_crab | True | True | 243.74
239 | ILSVRC2012_val_00000239.JPEG | 445 | bikini | 445 | bikini | True | True | 243.57
240 | ILSVRC2012_val_00000240.JPEG | 702 | parallel_bars | 422 | barbell | False | True | 269.98
241 | ILSVRC2012_val_00000241.JPEG | 532 | dining_table | 532 | dining_table | True | True | 390.84
242 | ILSVRC2012_val_00000242.JPEG | 366 | gorilla | 366 | gorilla | True | True | 298.88
243 | ILSVRC2012_val_00000243.JPEG | 678 | neck_brace | 678 | neck_brace | True | True | 300.37
244 | ILSVRC2012_val_00000244.JPEG | 764 | rifle | 764 | rifle | True | True | 327.95
245 | ILSVRC2012_val_00000245.JPEG | 125 | hermit_crab | 125 | hermit_crab | True | True | 313.03
246 | ILSVRC2012_val_00000246.JPEG | 349 | bighorn | 349 | bighorn | True | True | 294.67
247 | ILSVRC2012_val_00000247.JPEG | 13 | junco | 13 | junco | True | True | 292.37
248 | ILSVRC2012_val_00000248.JPEG | 179 | Staffordshire_bullterrier | 179 | Staffordshire_bullterrier | True | True | 294.01
249 | ILSVRC2012_val_00000249.JPEG | 522 | croquet_ball | 522 | croquet_ball | True | True | 299.72
250 | ILSVRC2012_val_00000250.JPEG | 493 | chiffonier | 894 | wardrobe | False | True | 299.28
251 | ILSVRC2012_val_00000251.JPEG | 989 | hip | 989 | hip | True | True | 295.52
252 | ILSVRC2012_val_00000252.JPEG | 720 | pill_bottle | 720 | pill_bottle | True | True | 297.34
253 | ILSVRC2012_val_00000253.JPEG | 438 | beaker | 438 | beaker | True | True | 292.58
254 | ILSVRC2012_val_00000254.JPEG | 660 | mobile_home | 660 | mobile_home | True | True | 295.42
255 | ILSVRC2012_val_00000255.JPEG | 983 | scuba_diver | 801 | snorkel | False | True | 294.42
256 | ILSVRC2012_val_00000256.JPEG | 533 | dishrag | 533 | dishrag | True | True | 303.93
257 | ILSVRC2012_val_00000257.JPEG | 487 | cellular_telephone | 487 | cellular_telephone | True | True | 294.28
258 | ILSVRC2012_val_00000258.JPEG | 27 | eft | 27 | eft | True | True | 298.84
259 | ILSVRC2012_val_00000259.JPEG | 644 | matchstick | 644 | matchstick | True | True | 299.71
260 | ILSVRC2012_val_00000260.JPEG | 750 | quilt | 750 | quilt | True | True | 300.43
261 | ILSVRC2012_val_00000261.JPEG | 865 | toyshop | 865 | toyshop | True | True | 299.19
262 | ILSVRC2012_val_00000262.JPEG | 1 | goldfish | 1 | goldfish | True | True | 297.76
263 | ILSVRC2012_val_00000263.JPEG | 176 | Saluki | 176 | Saluki | True | True | 305.12
264 | ILSVRC2012_val_00000264.JPEG | 694 | paddlewheel | 694 | paddlewheel | True | True | 308.80
265 | ILSVRC2012_val_00000265.JPEG | 695 | padlock | 695 | padlock | True | True | 305.70
266 | ILSVRC2012_val_00000266.JPEG | 798 | slide_rule | 798 | slide_rule | True | True | 293.57
267 | ILSVRC2012_val_00000267.JPEG | 925 | consomme | 925 | consomme | True | True | 319.85
268 | ILSVRC2012_val_00000268.JPEG | 413 | assault_rifle | 413 | assault_rifle | True | True | 440.77
269 | ILSVRC2012_val_00000269.JPEG | 250 | Siberian_husky | 270 | white_wolf | False | False | 307.24
270 | ILSVRC2012_val_00000270.JPEG | 970 | alp | 972 | cliff | False | True | 301.48
271 | ILSVRC2012_val_00000271.JPEG | 821 | steel_arch_bridge | 821 | steel_arch_bridge | True | True | 307.03
272 | ILSVRC2012_val_00000272.JPEG | 421 | bannister | 421 | bannister | True | True | 294.49
273 | ILSVRC2012_val_00000273.JPEG | 361 | skunk | 361 | skunk | True | True | 299.58
274 | ILSVRC2012_val_00000274.JPEG | 920 | traffic_light | 920 | traffic_light | True | True | 296.93
275 | ILSVRC2012_val_00000275.JPEG | 761 | remote_control | 761 | remote_control | True | True | 308.63
276 | ILSVRC2012_val_00000276.JPEG | 27 | eft | 27 | eft | True | True | 283.52
277 | ILSVRC2012_val_00000277.JPEG | 676 | muzzle | 464 | buckle | False | True | 291.34
278 | ILSVRC2012_val_00000278.JPEG | 92 | bee_eater | 92 | bee_eater | True | True | 296.79
279 | ILSVRC2012_val_00000279.JPEG | 194 | Dandie_Dinmont | 194 | Dandie_Dinmont | True | True | 295.94
280 | ILSVRC2012_val_00000280.JPEG | 897 | washer | 897 | washer | True | True | 295.34
281 | ILSVRC2012_val_00000281.JPEG | 612 | jinrikisha | 612 | jinrikisha | True | True | 297.95
282 | ILSVRC2012_val_00000282.JPEG | 610 | jersey | 918 | crossword_puzzle | False | True | 318.82
283 | ILSVRC2012_val_00000283.JPEG | 283 | Persian_cat | 283 | Persian_cat | True | True | 307.34
284 | ILSVRC2012_val_00000284.JPEG | 881 | upright | 881 | upright | True | True | 318.32
285 | ILSVRC2012_val_00000285.JPEG | 906 | Windsor_tie | 906 | Windsor_tie | True | True | 308.43
286 | ILSVRC2012_val_00000286.JPEG | 899 | water_jug | 899 | water_jug | True | True | 292.56
287 | ILSVRC2012_val_00000287.JPEG | 426 | barometer | 426 | barometer | True | True | 313.72
288 | ILSVRC2012_val_00000288.JPEG | 554 | fireboat | 554 | fireboat | True | True | 301.14
289 | ILSVRC2012_val_00000289.JPEG | 403 | aircraft_carrier | 403 | aircraft_carrier | True | True | 301.11
290 | ILSVRC2012_val_00000290.JPEG | 826 | stopwatch | 531 | digital_watch | False | True | 295.59
291 | ILSVRC2012_val_00000291.JPEG | 869 | trench_coat | 869 | trench_coat | True | True | 300.67
292 | ILSVRC2012_val_00000292.JPEG | 730 | plow | 856 | thresher | False | True | 302.10
293 | ILSVRC2012_val_00000293.JPEG | 0 | tench | 0 | tench | True | True | 298.29
294 | ILSVRC2012_val_00000294.JPEG | 866 | tractor | 866 | tractor | True | True | 295.87
295 | ILSVRC2012_val_00000295.JPEG | 580 | greenhouse | 580 | greenhouse | True | True | 296.27
296 | ILSVRC2012_val_00000296.JPEG | 888 | viaduct | 888 | viaduct | True | True | 305.20
297 | ILSVRC2012_val_00000297.JPEG | 43 | frilled_lizard | 43 | frilled_lizard | True | True | 507.18
298 | ILSVRC2012_val_00000298.JPEG | 64 | green_mamba | 64 | green_mamba | True | True | 292.58
299 | ILSVRC2012_val_00000299.JPEG | 69 | trilobite | 69 | trilobite | True | True | 306.17
300 | ILSVRC2012_val_00000300.JPEG | 176 | Saluki | 176 | Saluki | True | True | 307.20
301 | ILSVRC2012_val_00000301.JPEG | 329 | sea_cucumber | 65 | sea_snake | False | True | 289.16
302 | ILSVRC2012_val_00000302.JPEG | 469 | caldron | 469 | caldron | True | True | 294.66
303 | ILSVRC2012_val_00000303.JPEG | 292 | tiger | 288 | leopard | False | False | 302.49
304 | ILSVRC2012_val_00000304.JPEG | 991 | coral_fungus | 991 | coral_fungus | True | True | 314.51
305 | ILSVRC2012_val_00000305.JPEG | 591 | handkerchief | 591 | handkerchief | True | True | 281.27
306 | ILSVRC2012_val_00000306.JPEG | 346 | water_buffalo | 346 | water_buffalo | True | True | 298.18
307 | ILSVRC2012_val_00000307.JPEG | 1 | goldfish | 1 | goldfish | True | True | 294.63
308 | ILSVRC2012_val_00000308.JPEG | 607 | jack-o'-lantern | 607 | jack-o'-lantern | True | True | 298.23
309 | ILSVRC2012_val_00000309.JPEG | 934 | hotdog | 934 | hotdog | True | True | 302.74
310 | ILSVRC2012_val_00000310.JPEG | 784 | screwdriver | 828 | strainer | False | False | 290.62
311 | ILSVRC2012_val_00000311.JPEG | 572 | goblet | 572 | goblet | True | True | 302.18
312 | ILSVRC2012_val_00000312.JPEG | 389 | barracouta | 389 | barracouta | True | True | 303.41
313 | ILSVRC2012_val_00000313.JPEG | 979 | valley | 979 | valley | True | True | 293.29
314 | ILSVRC2012_val_00000314.JPEG | 654 | minibus | 656 | minivan | False | True | 299.15
315 | ILSVRC2012_val_00000315.JPEG | 420 | banjo | 420 | banjo | True | True | 290.91
316 | ILSVRC2012_val_00000316.JPEG | 390 | eel | 390 | eel | True | True | 296.39
317 | ILSVRC2012_val_00000317.JPEG | 702 | parallel_bars | 702 | parallel_bars | True | True | 299.65
318 | ILSVRC2012_val_00000318.JPEG | 24 | great_grey_owl | 24 | great_grey_owl | True | True | 312.94
319 | ILSVRC2012_val_00000319.JPEG | 102 | echidna | 102 | echidna | True | True | 319.20
320 | ILSVRC2012_val_00000320.JPEG | 949 | strawberry | 949 | strawberry | True | True | 382.47
321 | ILSVRC2012_val_00000321.JPEG | 508 | computer_keyboard | 508 | computer_keyboard | True | True | 382.52
322 | ILSVRC2012_val_00000322.JPEG | 361 | skunk | 361 | skunk | True | True | 240.84
323 | ILSVRC2012_val_00000323.JPEG | 280 | grey_fox | 280 | grey_fox | True | True | 213.86
324 | ILSVRC2012_val_00000324.JPEG | 65 | sea_snake | 65 | sea_snake | True | True | 212.97
325 | ILSVRC2012_val_00000325.JPEG | 777 | scabbard | 777 | scabbard | True | True | 212.88
326 | ILSVRC2012_val_00000326.JPEG | 359 | black-footed_ferret | 359 | black-footed_ferret | True | True | 217.90
327 | ILSVRC2012_val_00000327.JPEG | 165 | black-and-tan_coonhound | 234 | Rottweiler | False | True | 214.11
328 | ILSVRC2012_val_00000328.JPEG | 21 | kite | 21 | kite | True | True | 215.45
329 | ILSVRC2012_val_00000329.JPEG | 7 | cock | 7 | cock | True | True | 217.38
330 | ILSVRC2012_val_00000330.JPEG | 525 | dam | 525 | dam | True | True | 217.05
331 | ILSVRC2012_val_00000331.JPEG | 760 | refrigerator | 760 | refrigerator | True | True | 214.98
332 | ILSVRC2012_val_00000332.JPEG | 938 | cauliflower | 938 | cauliflower | True | True | 219.89
333 | ILSVRC2012_val_00000333.JPEG | 254 | pug | 254 | pug | True | True | 221.71
334 | ILSVRC2012_val_00000334.JPEG | 733 | pole | 840 | swab | False | True | 219.39
335 | ILSVRC2012_val_00000335.JPEG | 707 | pay-phone | 707 | pay-phone | True | True | 218.28
336 | ILSVRC2012_val_00000336.JPEG | 463 | bucket | 463 | bucket | True | True | 224.56
337 | ILSVRC2012_val_00000337.JPEG | 60 | night_snake | 62 | rock_python | False | True | 219.85
338 | ILSVRC2012_val_00000338.JPEG | 887 | vestment | 887 | vestment | True | True | 213.44
339 | ILSVRC2012_val_00000339.JPEG | 531 | digital_watch | 477 | carpenter's_kit | False | False | 216.13
340 | ILSVRC2012_val_00000340.JPEG | 380 | titi | 380 | titi | True | True | 227.52
341 | ILSVRC2012_val_00000341.JPEG | 982 | groom | 982 | groom | True | True | 224.21
342 | ILSVRC2012_val_00000342.JPEG | 305 | dung_beetle | 305 | dung_beetle | True | True | 212.41
343 | ILSVRC2012_val_00000343.JPEG | 355 | llama | 355 | llama | True | True | 215.60
344 | ILSVRC2012_val_00000344.JPEG | 503 | cocktail_shaker | 503 | cocktail_shaker | True | True | 222.09
345 | ILSVRC2012_val_00000345.JPEG | 818 | spotlight | 745 | projector | False | True | 221.68
346 | ILSVRC2012_val_00000346.JPEG | 495 | china_cabinet | 495 | china_cabinet | True | True | 216.82
347 | ILSVRC2012_val_00000347.JPEG | 472 | canoe | 472 | canoe | True | True | 216.37
348 | ILSVRC2012_val_00000348.JPEG | 293 | cheetah | 293 | cheetah | True | True | 212.22
349 | ILSVRC2012_val_00000349.JPEG | 816 | spindle | 816 | spindle | True | True | 212.77
350 | ILSVRC2012_val_00000350.JPEG | 195 | Boston_bull | 195 | Boston_bull | True | True | 213.83
351 | ILSVRC2012_val_00000351.JPEG | 904 | window_screen | 738 | pot | False | True | 212.48
352 | ILSVRC2012_val_00000352.JPEG | 475 | car_mirror | 475 | car_mirror | True | True | 217.23
353 | ILSVRC2012_val_00000353.JPEG | 481 | cassette | 481 | cassette | True | True | 210.53
354 | ILSVRC2012_val_00000354.JPEG | 431 | bassinet | 431 | bassinet | True | True | 213.89
355 | ILSVRC2012_val_00000355.JPEG | 260 | chow | 260 | chow | True | True | 211.96
356 | ILSVRC2012_val_00000356.JPEG | 130 | flamingo | 130 | flamingo | True | True | 216.52
357 | ILSVRC2012_val_00000357.JPEG | 627 | limousine | 627 | limousine | True | True | 214.17
358 | ILSVRC2012_val_00000358.JPEG | 460 | breakwater | 978 | seashore | False | True | 215.92
359 | ILSVRC2012_val_00000359.JPEG | 622 | lens_cap | 622 | lens_cap | True | True | 213.74
360 | ILSVRC2012_val_00000360.JPEG | 696 | paintbrush | 673 | mouse | False | False | 212.99
361 | ILSVRC2012_val_00000361.JPEG | 300 | tiger_beetle | 300 | tiger_beetle | True | True | 227.10
362 | ILSVRC2012_val_00000362.JPEG | 37 | box_turtle | 37 | box_turtle | True | True | 217.21
363 | ILSVRC2012_val_00000363.JPEG | 133 | bittern | 133 | bittern | True | True | 221.35
364 | ILSVRC2012_val_00000364.JPEG | 637 | mailbox | 637 | mailbox | True | True | 217.56
365 | ILSVRC2012_val_00000365.JPEG | 675 | moving_van | 867 | trailer_truck | False | True | 215.34
366 | ILSVRC2012_val_00000366.JPEG | 465 | bulletproof_vest | 465 | bulletproof_vest | True | True | 215.72
367 | ILSVRC2012_val_00000367.JPEG | 592 | hard_disc | 592 | hard_disc | True | True | 213.98
368 | ILSVRC2012_val_00000368.JPEG | 741 | prayer_rug | 741 | prayer_rug | True | True | 213.04
369 | ILSVRC2012_val_00000369.JPEG | 895 | warplane | 895 | warplane | True | True | 213.20
370 | ILSVRC2012_val_00000370.JPEG | 91 | coucal | 91 | coucal | True | True | 212.49
371 | ILSVRC2012_val_00000371.JPEG | 109 | brain_coral | 109 | brain_coral | True | True | 215.54
372 | ILSVRC2012_val_00000372.JPEG | 582 | grocery_store | 778 | scale | False | True | 217.33
373 | ILSVRC2012_val_00000373.JPEG | 694 | paddlewheel | 694 | paddlewheel | True | True | 211.15
374 | ILSVRC2012_val_00000374.JPEG | 546 | electric_guitar | 546 | electric_guitar | True | True | 213.01
375 | ILSVRC2012_val_00000375.JPEG | 208 | Labrador_retriever | 208 | Labrador_retriever | True | True | 215.53
376 | ILSVRC2012_val_00000376.JPEG | 488 | chain | 488 | chain | True | True | 212.19
377 | ILSVRC2012_val_00000377.JPEG | 786 | sewing_machine | 786 | sewing_machine | True | True | 213.64
378 | ILSVRC2012_val_00000378.JPEG | 959 | carbonara | 959 | carbonara | True | True | 212.02
379 | ILSVRC2012_val_00000379.JPEG | 192 | cairn | 192 | cairn | True | True | 216.43
380 | ILSVRC2012_val_00000380.JPEG | 834 | suit | 834 | suit | True | True | 214.97
381 | ILSVRC2012_val_00000381.JPEG | 879 | umbrella | 879 | umbrella | True | True | 215.93
382 | ILSVRC2012_val_00000382.JPEG | 649 | megalith | 649 | megalith | True | True | 212.72
383 | ILSVRC2012_val_00000383.JPEG | 228 | komondor | 228 | komondor | True | True | 212.11
384 | ILSVRC2012_val_00000384.JPEG | 621 | lawn_mower | 621 | lawn_mower | True | True | 217.69
385 | ILSVRC2012_val_00000385.JPEG | 630 | Loafer | 703 | park_bench | False | True | 213.20
386 | ILSVRC2012_val_00000386.JPEG | 107 | jellyfish | 107 | jellyfish | True | True | 213.15
387 | ILSVRC2012_val_00000387.JPEG | 598 | home_theater | 598 | home_theater | True | True | 218.56
388 | ILSVRC2012_val_00000388.JPEG | 420 | banjo | 420 | banjo | True | True | 213.32
389 | ILSVRC2012_val_00000389.JPEG | 134 | crane | 132 | American_egret | False | True | 212.20
390 | ILSVRC2012_val_00000390.JPEG | 133 | bittern | 133 | bittern | True | True | 215.47
391 | ILSVRC2012_val_00000391.JPEG | 185 | Norfolk_terrier | 185 | Norfolk_terrier | True | True | 214.51
392 | ILSVRC2012_val_00000392.JPEG | 471 | cannon | 471 | cannon | True | True | 213.52
393 | ILSVRC2012_val_00000393.JPEG | 230 | Shetland_sheepdog | 230 | Shetland_sheepdog | True | True | 212.77
394 | ILSVRC2012_val_00000394.JPEG | 974 | geyser | 974 | geyser | True | True | 213.36
395 | ILSVRC2012_val_00000395.JPEG | 74 | garden_spider | 74 | garden_spider | True | True | 213.44
396 | ILSVRC2012_val_00000396.JPEG | 76 | tarantula | 76 | tarantula | True | True | 215.71
397 | ILSVRC2012_val_00000397.JPEG | 852 | tennis_ball | 852 | tennis_ball | True | True | 216.36
398 | ILSVRC2012_val_00000398.JPEG | 383 | Madagascar_cat | 853 | thatch | False | True | 228.32
399 | ILSVRC2012_val_00000399.JPEG | 267 | standard_poodle | 267 | standard_poodle | True | True | 213.77
400 | ILSVRC2012_val_00000400.JPEG | 419 | Band_Aid | 929 | ice_lolly | False | True | 220.73
401 | ILSVRC2012_val_00000401.JPEG | 359 | black-footed_ferret | 359 | black-footed_ferret | True | True | 220.44
402 | ILSVRC2012_val_00000402.JPEG | 484 | catamaran | 871 | trimaran | False | True | 218.98
403 | ILSVRC2012_val_00000403.JPEG | 510 | container_ship | 510 | container_ship | True | True | 218.23
404 | ILSVRC2012_val_00000404.JPEG | 33 | loggerhead | 33 | loggerhead | True | True | 238.70
405 | ILSVRC2012_val_00000405.JPEG | 177 | Scottish_deerhound | 177 | Scottish_deerhound | True | True | 218.91
406 | ILSVRC2012_val_00000406.JPEG | 935 | mashed_potato | 935 | mashed_potato | True | True | 217.80
407 | ILSVRC2012_val_00000407.JPEG | 310 | ant | 310 | ant | True | True | 217.71
408 | ILSVRC2012_val_00000408.JPEG | 998 | ear | 998 | ear | True | True | 217.33
409 | ILSVRC2012_val_00000409.JPEG | 270 | white_wolf | 270 | white_wolf | True | True | 220.25
410 | ILSVRC2012_val_00000410.JPEG | 598 | home_theater | 598 | home_theater | True | True | 212.45
411 | ILSVRC2012_val_00000411.JPEG | 199 | Scotch_terrier | 199 | Scotch_terrier | True | True | 242.06
412 | ILSVRC2012_val_00000412.JPEG | 998 | ear | 998 | ear | True | True | 237.51
413 | ILSVRC2012_val_00000413.JPEG | 836 | sunglass | 701 | parachute | False | False | 220.19
414 | ILSVRC2012_val_00000414.JPEG | 14 | indigo_bunting | 14 | indigo_bunting | True | True | 215.49
415 | ILSVRC2012_val_00000415.JPEG | 97 | drake | 97 | drake | True | True | 213.17
416 | ILSVRC2012_val_00000416.JPEG | 856 | thresher | 856 | thresher | True | True | 212.05
417 | ILSVRC2012_val_00000417.JPEG | 398 | abacus | 398 | abacus | True | True | 214.65
418 | ILSVRC2012_val_00000418.JPEG | 319 | dragonfly | 319 | dragonfly | True | True | 211.31
419 | ILSVRC2012_val_00000419.JPEG | 549 | envelope | 446 | binder | False | True | 212.53
420 | ILSVRC2012_val_00000420.JPEG | 92 | bee_eater | 92 | bee_eater | True | True | 227.32
421 | ILSVRC2012_val_00000421.JPEG | 765 | rocking_chair | 765 | rocking_chair | True | True | 215.31
422 | ILSVRC2012_val_00000422.JPEG | 412 | ashcan | 412 | ashcan | True | True | 211.41
423 | ILSVRC2012_val_00000423.JPEG | 945 | bell_pepper | 945 | bell_pepper | True | True | 218.16
424 | ILSVRC2012_val_00000424.JPEG | 160 | Afghan_hound | 160 | Afghan_hound | True | True | 219.55
425 | ILSVRC2012_val_00000425.JPEG | 265 | toy_poodle | 266 | miniature_poodle | False | True | 218.99
426 | ILSVRC2012_val_00000426.JPEG | 638 | maillot | 639 | maillot | False | True | 217.53
427 | ILSVRC2012_val_00000427.JPEG | 619 | lampshade | 846 | table_lamp | False | True | 211.71
428 | ILSVRC2012_val_00000428.JPEG | 722 | ping-pong_ball | 722 | ping-pong_ball | True | True | 216.78
429 | ILSVRC2012_val_00000429.JPEG | 183 | Kerry_blue_terrier | 183 | Kerry_blue_terrier | True | True | 220.88
430 | ILSVRC2012_val_00000430.JPEG | 674 | mousetrap | 674 | mousetrap | True | True | 215.11
431 | ILSVRC2012_val_00000431.JPEG | 468 | cab | 468 | cab | True | True | 212.47
432 | ILSVRC2012_val_00000432.JPEG | 468 | cab | 468 | cab | True | True | 212.99
433 | ILSVRC2012_val_00000433.JPEG | 885 | velvet | 748 | purse | False | False | 223.62
434 | ILSVRC2012_val_00000434.JPEG | 675 | moving_van | 675 | moving_van | True | True | 230.93
435 | ILSVRC2012_val_00000435.JPEG | 636 | mailbag | 636 | mailbag | True | True | 217.49
436 | ILSVRC2012_val_00000436.JPEG | 196 | miniature_schnauzer | 198 | standard_schnauzer | False | True | 221.03
437 | ILSVRC2012_val_00000437.JPEG | 912 | worm_fence | 912 | worm_fence | True | True | 220.19
438 | ILSVRC2012_val_00000438.JPEG | 721 | pillow | 721 | pillow | True | True | 244.16
439 | ILSVRC2012_val_00000439.JPEG | 16 | bulbul | 16 | bulbul | True | True | 268.26
440 | ILSVRC2012_val_00000440.JPEG | 199 | Scotch_terrier | 199 | Scotch_terrier | True | True | 214.06
441 | ILSVRC2012_val_00000441.JPEG | 175 | otterhound | 175 | otterhound | True | True | 220.53
442 | ILSVRC2012_val_00000442.JPEG | 775 | sarong | 775 | sarong | True | True | 221.21
443 | ILSVRC2012_val_00000443.JPEG | 944 | artichoke | 944 | artichoke | True | True | 491.57
444 | ILSVRC2012_val_00000444.JPEG | 350 | ibex | 350 | ibex | True | True | 309.35
445 | ILSVRC2012_val_00000445.JPEG | 557 | flagpole | 557 | flagpole | True | True | 315.14
446 | ILSVRC2012_val_00000446.JPEG | 361 | skunk | 361 | skunk | True | True | 286.94
447 | ILSVRC2012_val_00000447.JPEG | 361 | skunk | 361 | skunk | True | True | 295.78
448 | ILSVRC2012_val_00000448.JPEG | 594 | harp | 594 | harp | True | True | 293.66
449 | ILSVRC2012_val_00000449.JPEG | 861 | toilet_seat | 861 | toilet_seat | True | True | 300.88
450 | ILSVRC2012_val_00000450.JPEG | 257 | Great_Pyrenees | 208 | Labrador_retriever | False | True | 294.96
451 | ILSVRC2012_val_00000451.JPEG | 606 | iron | 606 | iron | True | True | 291.19
452 | ILSVRC2012_val_00000452.JPEG | 734 | police_van | 734 | police_van | True | True | 303.40
453 | ILSVRC2012_val_00000453.JPEG | 767 | rubber_eraser | 767 | rubber_eraser | True | True | 301.05
454 | ILSVRC2012_val_00000454.JPEG | 746 | puck | 746 | puck | True | True | 291.05
455 | ILSVRC2012_val_00000455.JPEG | 788 | shoe_shop | 788 | shoe_shop | True | True | 293.99
456 | ILSVRC2012_val_00000456.JPEG | 346 | water_buffalo | 346 | water_buffalo | True | True | 299.30
457 | ILSVRC2012_val_00000457.JPEG | 153 | Maltese_dog | 203 | West_Highland_white_terrier | False | True | 300.09
458 | ILSVRC2012_val_00000458.JPEG | 739 | potter's_wheel | 739 | potter's_wheel | True | True | 300.02
459 | ILSVRC2012_val_00000459.JPEG | 414 | backpack | 414 | backpack | True | True | 292.10
460 | ILSVRC2012_val_00000460.JPEG | 915 | yurt | 915 | yurt | True | True | 299.70
461 | ILSVRC2012_val_00000461.JPEG | 940 | spaghetti_squash | 940 | spaghetti_squash | True | True | 294.36
462 | ILSVRC2012_val_00000462.JPEG | 152 | Japanese_spaniel | 152 | Japanese_spaniel | True | True | 289.20
463 | ILSVRC2012_val_00000463.JPEG | 943 | cucumber | 943 | cucumber | True | True | 296.45
464 | ILSVRC2012_val_00000464.JPEG | 849 | teapot | 849 | teapot | True | True | 309.40
465 | ILSVRC2012_val_00000465.JPEG | 712 | Petri_dish | 712 | Petri_dish | True | True | 298.33
466 | ILSVRC2012_val_00000466.JPEG | 100 | black_swan | 100 | black_swan | True | True | 299.04
467 | ILSVRC2012_val_00000467.JPEG | 546 | electric_guitar | 546 | electric_guitar | True | True | 293.23
468 | ILSVRC2012_val_00000468.JPEG | 744 | projectile | 657 | missile | False | True | 289.27
469 | ILSVRC2012_val_00000469.JPEG | 764 | rifle | 764 | rifle | True | True | 308.21
470 | ILSVRC2012_val_00000470.JPEG | 141 | redshank | 141 | redshank | True | True | 299.94
471 | ILSVRC2012_val_00000471.JPEG | 39 | common_iguana | 39 | common_iguana | True | True | 290.44
472 | ILSVRC2012_val_00000472.JPEG | 993 | gyromitra | 993 | gyromitra | True | True | 300.88
473 | ILSVRC2012_val_00000473.JPEG | 758 | reel | 758 | reel | True | True | 473.58
474 | ILSVRC2012_val_00000474.JPEG | 190 | Sealyham_terrier | 190 | Sealyham_terrier | True | True | 301.97
475 | ILSVRC2012_val_00000475.JPEG | 888 | viaduct | 888 | viaduct | True | True | 292.61
476 | ILSVRC2012_val_00000476.JPEG | 18 | magpie | 18 | magpie | True | True | 287.79
477 | ILSVRC2012_val_00000477.JPEG | 584 | hair_slide | 584 | hair_slide | True | True | 312.56
478 | ILSVRC2012_val_00000478.JPEG | 341 | hog | 341 | hog | True | True | 293.76
479 | ILSVRC2012_val_00000479.JPEG | 875 | trombone | 875 | trombone | True | True | 306.83
480 | ILSVRC2012_val_00000480.JPEG | 359 | black-footed_ferret | 359 | black-footed_ferret | True | True | 316.14
481 | ILSVRC2012_val_00000481.JPEG | 388 | giant_panda | 388 | giant_panda | True | True | 315.02
482 | ILSVRC2012_val_00000482.JPEG | 894 | wardrobe | 894 | wardrobe | True | True | 289.54
483 | ILSVRC2012_val_00000483.JPEG | 437 | beacon | 437 | beacon | True | True | 291.73
484 | ILSVRC2012_val_00000484.JPEG | 987 | corn | 998 | ear | False | True | 293.79
485 | ILSVRC2012_val_00000485.JPEG | 517 | crane | 517 | crane | True | True | 300.84
486 | ILSVRC2012_val_00000486.JPEG | 372 | baboon | 372 | baboon | True | True | 316.86
487 | ILSVRC2012_val_00000487.JPEG | 286 | cougar | 286 | cougar | True | True | 294.36
488 | ILSVRC2012_val_00000488.JPEG | 662 | modem | 662 | modem | True | True | 310.84
489 | ILSVRC2012_val_00000489.JPEG | 713 | photocopier | 713 | photocopier | True | True | 309.46
490 | ILSVRC2012_val_00000490.JPEG | 915 | yurt | 915 | yurt | True | True | 297.46
491 | ILSVRC2012_val_00000491.JPEG | 964 | potpie | 964 | potpie | True | True | 290.87
492 | ILSVRC2012_val_00000492.JPEG | 146 | albatross | 146 | albatross | True | True | 308.50
493 | ILSVRC2012_val_00000493.JPEG | 529 | diaper | 529 | diaper | True | True | 299.52
494 | ILSVRC2012_val_00000494.JPEG | 416 | balance_beam | 416 | balance_beam | True | True | 297.65
495 | ILSVRC2012_val_00000495.JPEG | 376 | proboscis_monkey | 376 | proboscis_monkey | True | True | 312.70
496 | ILSVRC2012_val_00000496.JPEG | 147 | grey_whale | 147 | grey_whale | True | True | 298.62
497 | ILSVRC2012_val_00000497.JPEG | 902 | whistle | 902 | whistle | True | True | 304.35
498 | ILSVRC2012_val_00000498.JPEG | 26 | common_newt | 26 | common_newt | True | True | 293.00
499 | ILSVRC2012_val_00000499.JPEG | 398 | abacus | 398 | abacus | True | True | 301.63
500 | ILSVRC2012_val_00000500.JPEG | 175 | otterhound | 175 | otterhound | True | True | 299.93
501 | ILSVRC2012_val_00000501.JPEG | 270 | white_wolf | 270 | white_wolf | True | True | 296.09
502 | ILSVRC2012_val_00000502.JPEG | 335 | fox_squirrel | 335 | fox_squirrel | True | True | 296.88
503 | ILSVRC2012_val_00000503.JPEG | 532 | dining_table | 532 | dining_table | True | True | 537.13
504 | ILSVRC2012_val_00000504.JPEG | 540 | drilling_platform | 540 | drilling_platform | True | True | 302.46
505 | ILSVRC2012_val_00000505.JPEG | 607 | jack-o'-lantern | 607 | jack-o'-lantern | True | True | 222.93
506 | ILSVRC2012_val_00000506.JPEG | 495 | china_cabinet | 495 | china_cabinet | True | True | 220.41
507 | ILSVRC2012_val_00000507.JPEG | 222 | kuvasz | 222 | kuvasz | True | True | 212.68
508 | ILSVRC2012_val_00000508.JPEG | 801 | snorkel | 801 | snorkel | True | True | 215.77
509 | ILSVRC2012_val_00000509.JPEG | 982 | groom | 576 | gondola | False | True | 220.50
510 | ILSVRC2012_val_00000510.JPEG | 304 | leaf_beetle | 301 | ladybug | False | True | 218.63
511 | ILSVRC2012_val_00000511.JPEG | 166 | Walker_hound | 166 | Walker_hound | True | True | 220.95
512 | ILSVRC2012_val_00000512.JPEG | 56 | king_snake | 56 | king_snake | True | True | 216.84
513 | ILSVRC2012_val_00000513.JPEG | 868 | tray | 868 | tray | True | True | 213.45
514 | ILSVRC2012_val_00000514.JPEG | 448 | birdhouse | 448 | birdhouse | True | True | 218.61
515 | ILSVRC2012_val_00000515.JPEG | 744 | projectile | 744 | projectile | True | True | 213.70
516 | ILSVRC2012_val_00000516.JPEG | 567 | frying_pan | 567 | frying_pan | True | True | 215.77
517 | ILSVRC2012_val_00000517.JPEG | 277 | red_fox | 278 | kit_fox | False | True | 215.82
518 | ILSVRC2012_val_00000518.JPEG | 298 | mongoose | 272 | coyote | False | False | 216.96
519 | ILSVRC2012_val_00000519.JPEG | 651 | microwave | 651 | microwave | True | True | 214.75
520 | ILSVRC2012_val_00000520.JPEG | 377 | marmoset | 377 | marmoset | True | True | 205.53
521 | ILSVRC2012_val_00000521.JPEG | 684 | ocarina | 684 | ocarina | True | True | 211.38
522 | ILSVRC2012_val_00000522.JPEG | 832 | stupa | 832 | stupa | True | True | 214.99
523 | ILSVRC2012_val_00000523.JPEG | 39 | common_iguana | 39 | common_iguana | True | True | 214.91
524 | ILSVRC2012_val_00000524.JPEG | 219 | cocker_spaniel | 219 | cocker_spaniel | True | True | 214.08
525 | ILSVRC2012_val_00000525.JPEG | 863 | totem_pole | 863 | totem_pole | True | True | 213.73
526 | ILSVRC2012_val_00000526.JPEG | 868 | tray | 868 | tray | True | True | 216.97
527 | ILSVRC2012_val_00000527.JPEG | 794 | shower_curtain | 794 | shower_curtain | True | True | 213.40
528 | ILSVRC2012_val_00000528.JPEG | 80 | black_grouse | 80 | black_grouse | True | True | 212.48
529 | ILSVRC2012_val_00000529.JPEG | 983 | scuba_diver | 983 | scuba_diver | True | True | 213.36
530 | ILSVRC2012_val_00000530.JPEG | 269 | timber_wolf | 347 | bison | False | True | 214.04
531 | ILSVRC2012_val_00000531.JPEG | 238 | Greater_Swiss_Mountain_dog | 238 | Greater_Swiss_Mountain_dog | True | True | 219.14
532 | ILSVRC2012_val_00000532.JPEG | 498 | cinema | 498 | cinema | True | True | 213.96
533 | ILSVRC2012_val_00000533.JPEG | 223 | schipperke | 223 | schipperke | True | True | 217.04
534 | ILSVRC2012_val_00000534.JPEG | 521 | Crock_Pot | 521 | Crock_Pot | True | True | 214.88
535 | ILSVRC2012_val_00000535.JPEG | 830 | stretcher | 830 | stretcher | True | True | 219.60
536 | ILSVRC2012_val_00000536.JPEG | 260 | chow | 260 | chow | True | True | 212.54
537 | ILSVRC2012_val_00000537.JPEG | 491 | chain_saw | 491 | chain_saw | True | True | 224.20
538 | ILSVRC2012_val_00000538.JPEG | 896 | washbasin | 896 | washbasin | True | True | 213.65
539 | ILSVRC2012_val_00000539.JPEG | 220 | Sussex_spaniel | 220 | Sussex_spaniel | True | True | 214.23
540 | ILSVRC2012_val_00000540.JPEG | 680 | nipple | 680 | nipple | True | True | 216.69
541 | ILSVRC2012_val_00000541.JPEG | 48 | Komodo_dragon | 48 | Komodo_dragon | True | True | 216.50
542 | ILSVRC2012_val_00000542.JPEG | 542 | drumstick | 542 | drumstick | True | True | 214.99
543 | ILSVRC2012_val_00000543.JPEG | 961 | dough | 930 | French_loaf | False | True | 213.96
544 | ILSVRC2012_val_00000544.JPEG | 820 | steam_locomotive | 820 | steam_locomotive | True | True | 299.18
545 | ILSVRC2012_val_00000545.JPEG | 148 | killer_whale | 148 | killer_whale | True | True | 395.83
546 | ILSVRC2012_val_00000546.JPEG | 114 | slug | 114 | slug | True | True | 261.99
547 | ILSVRC2012_val_00000547.JPEG | 99 | goose | 99 | goose | True | True | 227.44
548 | ILSVRC2012_val_00000548.JPEG | 143 | oystercatcher | 143 | oystercatcher | True | True | 213.16
549 | ILSVRC2012_val_00000549.JPEG | 691 | oxygen_mask | 570 | gasmask | False | True | 212.17
550 | ILSVRC2012_val_00000550.JPEG | 796 | ski_mask | 796 | ski_mask | True | True | 212.98
551 | ILSVRC2012_val_00000551.JPEG | 986 | yellow_lady's_slipper | 986 | yellow_lady's_slipper | True | True | 211.25
552 | ILSVRC2012_val_00000552.JPEG | 346 | water_buffalo | 346 | water_buffalo | True | True | 210.67
553 | ILSVRC2012_val_00000553.JPEG | 367 | chimpanzee | 367 | chimpanzee | True | True | 217.33
554 | ILSVRC2012_val_00000554.JPEG | 939 | zucchini | 939 | zucchini | True | True | 215.74
555 | ILSVRC2012_val_00000555.JPEG | 875 | trombone | 875 | trombone | True | True | 212.10
556 | ILSVRC2012_val_00000556.JPEG | 625 | lifeboat | 625 | lifeboat | True | True | 211.36
557 | ILSVRC2012_val_00000557.JPEG | 482 | cassette_player | 482 | cassette_player | True | True | 212.84
558 | ILSVRC2012_val_00000558.JPEG | 464 | buckle | 464 | buckle | True | True | 213.71
559 | ILSVRC2012_val_00000559.JPEG | 812 | space_shuttle | 812 | space_shuttle | True | True | 211.52
560 | ILSVRC2012_val_00000560.JPEG | 705 | passenger_car | 705 | passenger_car | True | True | 214.59
561 | ILSVRC2012_val_00000561.JPEG | 860 | tobacco_shop | 892 | wall_clock | False | True | 213.07
562 | ILSVRC2012_val_00000562.JPEG | 466 | bullet_train | 466 | bullet_train | True | True | 218.14
563 | ILSVRC2012_val_00000563.JPEG | 781 | scoreboard | 781 | scoreboard | True | True | 212.19
564 | ILSVRC2012_val_00000564.JPEG | 499 | cleaver | 499 | cleaver | True | True | 212.72
565 | ILSVRC2012_val_00000565.JPEG | 338 | guinea_pig | 338 | guinea_pig | True | True | 217.30
566 | ILSVRC2012_val_00000566.JPEG | 488 | chain | 679 | necklace | False | True | 212.25
567 | ILSVRC2012_val_00000567.JPEG | 858 | tile_roof | 858 | tile_roof | True | True | 219.98
568 | ILSVRC2012_val_00000568.JPEG | 795 | ski | 795 | ski | True | True | 211.47
569 | ILSVRC2012_val_00000569.JPEG | 437 | beacon | 437 | beacon | True | True | 214.71
570 | ILSVRC2012_val_00000570.JPEG | 11 | goldfinch | 11 | goldfinch | True | True | 209.89
571 | ILSVRC2012_val_00000571.JPEG | 625 | lifeboat | 625 | lifeboat | True | True | 216.46
572 | ILSVRC2012_val_00000572.JPEG | 965 | burrito | 965 | burrito | True | True | 211.62
573 | ILSVRC2012_val_00000573.JPEG | 874 | trolleybus | 874 | trolleybus | True | True | 215.76
574 | ILSVRC2012_val_00000574.JPEG | 928 | ice_cream | 954 | banana | False | True | 212.95
575 | ILSVRC2012_val_00000575.JPEG | 600 | hook | 600 | hook | True | True | 212.71
576 | ILSVRC2012_val_00000576.JPEG | 86 | partridge | 86 | partridge | True | True | 211.60
577 | ILSVRC2012_val_00000577.JPEG | 133 | bittern | 133 | bittern | True | True | 213.39
578 | ILSVRC2012_val_00000578.JPEG | 149 | dugong | 149 | dugong | True | True | 213.59
579 | ILSVRC2012_val_00000579.JPEG | 865 | toyshop | 865 | toyshop | True | True | 212.34
580 | ILSVRC2012_val_00000580.JPEG | 480 | cash_machine | 509 | confectionery | False | True | 215.21
581 | ILSVRC2012_val_00000581.JPEG | 325 | sulphur_butterfly | 325 | sulphur_butterfly | True | True | 210.88
582 | ILSVRC2012_val_00000582.JPEG | 499 | cleaver | 499 | cleaver | True | True | 215.89
583 | ILSVRC2012_val_00000583.JPEG | 834 | suit | 834 | suit | True | True | 211.97
584 | ILSVRC2012_val_00000584.JPEG | 421 | bannister | 506 | coil | False | True | 211.29
585 | ILSVRC2012_val_00000585.JPEG | 298 | mongoose | 298 | mongoose | True | True | 213.50
586 | ILSVRC2012_val_00000586.JPEG | 900 | water_tower | 900 | water_tower | True | True | 210.70
587 | ILSVRC2012_val_00000587.JPEG | 905 | window_shade | 905 | window_shade | True | True | 214.26
588 | ILSVRC2012_val_00000588.JPEG | 184 | Irish_terrier | 184 | Irish_terrier | True | True | 212.82
589 | ILSVRC2012_val_00000589.JPEG | 740 | power_drill | 740 | power_drill | True | True | 220.76
590 | ILSVRC2012_val_00000590.JPEG | 258 | Samoyed | 258 | Samoyed | True | True | 217.13
591 | ILSVRC2012_val_00000591.JPEG | 762 | restaurant | 762 | restaurant | True | True | 229.92
592 | ILSVRC2012_val_00000592.JPEG | 295 | American_black_bear | 295 | American_black_bear | True | True | 212.23
593 | ILSVRC2012_val_00000593.JPEG | 129 | spoonbill | 129 | spoonbill | True | True | 212.08
594 | ILSVRC2012_val_00000594.JPEG | 240 | Appenzeller | 238 | Greater_Swiss_Mountain_dog | False | True | 211.45
595 | ILSVRC2012_val_00000595.JPEG | 833 | submarine | 833 | submarine | True | True | 214.29
596 | ILSVRC2012_val_00000596.JPEG | 471 | cannon | 471 | cannon | True | True | 211.17
597 | ILSVRC2012_val_00000597.JPEG | 385 | Indian_elephant | 101 | tusker | False | True | 203.65
598 | ILSVRC2012_val_00000598.JPEG | 899 | water_jug | 898 | water_bottle | False | True | 210.22
599 | ILSVRC2012_val_00000599.JPEG | 162 | beagle | 162 | beagle | True | True | 215.03
600 | ILSVRC2012_val_00000600.JPEG | 288 | leopard | 288 | leopard | True | True | 210.72
601 | ILSVRC2012_val_00000601.JPEG | 450 | bobsled | 450 | bobsled | True | True | 210.69
602 | ILSVRC2012_val_00000602.JPEG | 850 | teddy | 850 | teddy | True | True | 211.76
603 | ILSVRC2012_val_00000603.JPEG | 227 | kelpie | 232 | Border_collie | False | True | 212.02
604 | ILSVRC2012_val_00000604.JPEG | 273 | dingo | 273 | dingo | True | True | 215.24
605 | ILSVRC2012_val_00000605.JPEG | 954 | banana | 954 | banana | True | True | 213.67
606 | ILSVRC2012_val_00000606.JPEG | 965 | burrito | 933 | cheeseburger | False | True | 215.10
607 | ILSVRC2012_val_00000607.JPEG | 611 | jigsaw_puzzle | 611 | jigsaw_puzzle | True | True | 211.60
608 | ILSVRC2012_val_00000608.JPEG | 643 | mask | 643 | mask | True | True | 213.71
609 | ILSVRC2012_val_00000609.JPEG | 147 | grey_whale | 147 | grey_whale | True | True | 210.70
610 | ILSVRC2012_val_00000610.JPEG | 290 | jaguar | 290 | jaguar | True | True | 210.91
611 | ILSVRC2012_val_00000611.JPEG | 866 | tractor | 866 | tractor | True | True | 211.41
612 | ILSVRC2012_val_00000612.JPEG | 186 | Norwich_terrier | 192 | cairn | False | True | 210.93
613 | ILSVRC2012_val_00000613.JPEG | 156 | Blenheim_spaniel | 156 | Blenheim_spaniel | True | True | 214.45
614 | ILSVRC2012_val_00000614.JPEG | 776 | sax | 875 | trombone | False | True | 210.92
615 | ILSVRC2012_val_00000615.JPEG | 775 | sarong | 775 | sarong | True | True | 213.68
616 | ILSVRC2012_val_00000616.JPEG | 998 | ear | 998 | ear | True | True | 211.66
617 | ILSVRC2012_val_00000617.JPEG | 333 | hamster | 333 | hamster | True | True | 214.83
618 | ILSVRC2012_val_00000618.JPEG | 325 | sulphur_butterfly | 325 | sulphur_butterfly | True | True | 210.53
619 | ILSVRC2012_val_00000619.JPEG | 572 | goblet | 572 | goblet | True | True | 211.51
620 | ILSVRC2012_val_00000620.JPEG | 927 | trifle | 927 | trifle | True | True | 212.26
621 | ILSVRC2012_val_00000621.JPEG | 744 | projectile | 744 | projectile | True | True | 209.91
622 | ILSVRC2012_val_00000622.JPEG | 777 | scabbard | 777 | scabbard | True | True | 215.21
623 | ILSVRC2012_val_00000623.JPEG | 833 | submarine | 833 | submarine | True | True | 210.28
624 | ILSVRC2012_val_00000624.JPEG | 551 | face_powder | 551 | face_powder | True | True | 215.75
625 | ILSVRC2012_val_00000625.JPEG | 301 | ladybug | 301 | ladybug | True | True | 213.27
626 | ILSVRC2012_val_00000626.JPEG | 716 | picket_fence | 716 | picket_fence | True | True | 217.74
627 | ILSVRC2012_val_00000627.JPEG | 848 | tape_player | 482 | cassette_player | False | True | 211.51
628 | ILSVRC2012_val_00000628.JPEG | 102 | echidna | 102 | echidna | True | True | 210.86
629 | ILSVRC2012_val_00000629.JPEG | 790 | shopping_basket | 791 | shopping_cart | False | True | 211.96
630 | ILSVRC2012_val_00000630.JPEG | 959 | carbonara | 959 | carbonara | True | True | 215.48
631 | ILSVRC2012_val_00000631.JPEG | 404 | airliner | 404 | airliner | True | True | 211.09
632 | ILSVRC2012_val_00000632.JPEG | 987 | corn | 998 | ear | False | True | 212.51
633 | ILSVRC2012_val_00000633.JPEG | 415 | bakery | 415 | bakery | True | True | 218.71
634 | ILSVRC2012_val_00000634.JPEG | 455 | bottlecap | 455 | bottlecap | True | True | 214.11
635 | ILSVRC2012_val_00000635.JPEG | 242 | boxer | 242 | boxer | True | True | 215.49
636 | ILSVRC2012_val_00000636.JPEG | 600 | hook | 600 | hook | True | True | 212.63
637 | ILSVRC2012_val_00000637.JPEG | 517 | crane | 517 | crane | True | True | 213.87
638 | ILSVRC2012_val_00000638.JPEG | 16 | bulbul | 16 | bulbul | True | True | 211.63
639 | ILSVRC2012_val_00000639.JPEG | 320 | damselfly | 320 | damselfly | True | True | 216.15
640 | ILSVRC2012_val_00000640.JPEG | 632 | loudspeaker | 632 | loudspeaker | True | True | 214.62
641 | ILSVRC2012_val_00000641.JPEG | 568 | fur_coat | 568 | fur_coat | True | True | 210.48
642 | ILSVRC2012_val_00000642.JPEG | 338 | guinea_pig | 337 | beaver | False | True | 215.69
643 | ILSVRC2012_val_00000643.JPEG | 216 | clumber | 216 | clumber | True | True | 217.98
644 | ILSVRC2012_val_00000644.JPEG | 331 | hare | 331 | hare | True | True | 217.85
645 | ILSVRC2012_val_00000645.JPEG | 726 | plane | 726 | plane | True | True | 211.59
646 | ILSVRC2012_val_00000646.JPEG | 959 | carbonara | 959 | carbonara | True | True | 212.48
647 | ILSVRC2012_val_00000647.JPEG | 605 | iPod | 632 | loudspeaker | False | True | 211.65
648 | ILSVRC2012_val_00000648.JPEG | 134 | crane | 134 | crane | True | True | 215.71
649 | ILSVRC2012_val_00000649.JPEG | 677 | nail | 677 | nail | True | True | 211.77
650 | ILSVRC2012_val_00000650.JPEG | 288 | leopard | 288 | leopard | True | True | 214.58
651 | ILSVRC2012_val_00000651.JPEG | 10 | brambling | 10 | brambling | True | True | 214.93
652 | ILSVRC2012_val_00000652.JPEG | 718 | pier | 718 | pier | True | True | 226.47
653 | ILSVRC2012_val_00000653.JPEG | 852 | tennis_ball | 852 | tennis_ball | True | True | 205.30
654 | ILSVRC2012_val_00000654.JPEG | 440 | beer_bottle | 440 | beer_bottle | True | True | 209.80
655 | ILSVRC2012_val_00000655.JPEG | 104 | wallaby | 104 | wallaby | True | True | 222.72
656 | ILSVRC2012_val_00000656.JPEG | 712 | Petri_dish | 712 | Petri_dish | True | True | 208.32
657 | ILSVRC2012_val_00000657.JPEG | 388 | giant_panda | 388 | giant_panda | True | True | 212.47
658 | ILSVRC2012_val_00000658.JPEG | 261 | keeshond | 261 | keeshond | True | True | 207.24
659 | ILSVRC2012_val_00000659.JPEG | 609 | jeep | 803 | snowplow | False | False | 212.86
660 | ILSVRC2012_val_00000660.JPEG | 620 | laptop | 526 | desk | False | True | 205.68
661 | ILSVRC2012_val_00000661.JPEG | 341 | hog | 193 | Australian_terrier | False | True | 211.66
662 | ILSVRC2012_val_00000662.JPEG | 579 | grand_piano | 579 | grand_piano | True | True | 206.89
663 | ILSVRC2012_val_00000663.JPEG | 450 | bobsled | 450 | bobsled | True | True | 211.20
664 | ILSVRC2012_val_00000664.JPEG | 628 | liner | 628 | liner | True | True | 209.78
665 | ILSVRC2012_val_00000665.JPEG | 217 | English_springer | 217 | English_springer | True | True | 207.71
666 | ILSVRC2012_val_00000666.JPEG | 878 | typewriter_keyboard | 878 | typewriter_keyboard | True | True | 214.61
667 | ILSVRC2012_val_00000667.JPEG | 763 | revolver | 763 | revolver | True | True | 211.40
668 | ILSVRC2012_val_00000668.JPEG | 209 | Chesapeake_Bay_retriever | 209 | Chesapeake_Bay_retriever | True | True | 212.93
669 | ILSVRC2012_val_00000669.JPEG | 126 | isopod | 126 | isopod | True | True | 207.08
670 | ILSVRC2012_val_00000670.JPEG | 663 | monastery | 663 | monastery | True | True | 213.63
671 | ILSVRC2012_val_00000671.JPEG | 864 | tow_truck | 864 | tow_truck | True | True | 206.64
672 | ILSVRC2012_val_00000672.JPEG | 232 | Border_collie | 232 | Border_collie | True | True | 207.23
673 | ILSVRC2012_val_00000673.JPEG | 776 | sax | 776 | sax | True | True | 208.54
674 | ILSVRC2012_val_00000674.JPEG | 942 | butternut_squash | 942 | butternut_squash | True | True | 206.77
675 | ILSVRC2012_val_00000675.JPEG | 336 | marmot | 336 | marmot | True | True | 212.85
676 | ILSVRC2012_val_00000676.JPEG | 733 | pole | 733 | pole | True | True | 206.93
677 | ILSVRC2012_val_00000677.JPEG | 681 | notebook | 620 | laptop | False | True | 212.47
678 | ILSVRC2012_val_00000678.JPEG | 512 | corkscrew | 942 | butternut_squash | False | True | 208.84
679 | ILSVRC2012_val_00000679.JPEG | 78 | tick | 78 | tick | True | True | 210.79
680 | ILSVRC2012_val_00000680.JPEG | 668 | mosque | 668 | mosque | True | True | 206.59
681 | ILSVRC2012_val_00000681.JPEG | 699 | panpipe | 699 | panpipe | True | True | 214.32
682 | ILSVRC2012_val_00000682.JPEG | 746 | puck | 746 | puck | True | True | 214.17
683 | ILSVRC2012_val_00000683.JPEG | 46 | green_lizard | 39 | common_iguana | False | True | 220.79
684 | ILSVRC2012_val_00000684.JPEG | 618 | ladle | 618 | ladle | True | True | 223.00
685 | ILSVRC2012_val_00000685.JPEG | 330 | wood_rabbit | 330 | wood_rabbit | True | True | 228.73
686 | ILSVRC2012_val_00000686.JPEG | 615 | knee_pad | 615 | knee_pad | True | True | 215.70
687 | ILSVRC2012_val_00000687.JPEG | 427 | barrel | 427 | barrel | True | True | 221.72
688 | ILSVRC2012_val_00000688.JPEG | 62 | rock_python | 62 | rock_python | True | True | 222.63
689 | ILSVRC2012_val_00000689.JPEG | 116 | chiton | 116 | chiton | True | True | 216.08
690 | ILSVRC2012_val_00000690.JPEG | 127 | white_stork | 127 | white_stork | True | True | 219.34
691 | ILSVRC2012_val_00000691.JPEG | 955 | jackfruit | 955 | jackfruit | True | True | 219.08
692 | ILSVRC2012_val_00000692.JPEG | 306 | rhinoceros_beetle | 306 | rhinoceros_beetle | True | True | 224.91
693 | ILSVRC2012_val_00000693.JPEG | 425 | barn | 425 | barn | True | True | 217.60
694 | ILSVRC2012_val_00000694.JPEG | 190 | Sealyham_terrier | 190 | Sealyham_terrier | True | True | 225.06
695 | ILSVRC2012_val_00000695.JPEG | 370 | guenon | 370 | guenon | True | True | 217.59
696 | ILSVRC2012_val_00000696.JPEG | 187 | Yorkshire_terrier | 187 | Yorkshire_terrier | True | True | 218.05
697 | ILSVRC2012_val_00000697.JPEG | 971 | bubble | 971 | bubble | True | True | 221.60
698 | ILSVRC2012_val_00000698.JPEG | 534 | dishwasher | 411 | apron | False | True | 215.06
699 | ILSVRC2012_val_00000699.JPEG | 397 | puffer | 396 | lionfish | False | True | 220.14
700 | ILSVRC2012_val_00000700.JPEG | 657 | missile | 657 | missile | True | True | 218.88
701 | ILSVRC2012_val_00000701.JPEG | 840 | swab | 840 | swab | True | True | 218.80
702 | ILSVRC2012_val_00000702.JPEG | 718 | pier | 718 | pier | True | True | 217.38
703 | ILSVRC2012_val_00000703.JPEG | 116 | chiton | 116 | chiton | True | True | 222.70
704 | ILSVRC2012_val_00000704.JPEG | 836 | sunglass | 837 | sunglasses | False | True | 219.91
705 | ILSVRC2012_val_00000705.JPEG | 994 | stinkhorn | 994 | stinkhorn | True | True | 217.81
706 | ILSVRC2012_val_00000706.JPEG | 419 | Band_Aid | 419 | Band_Aid | True | True | 202.86
707 | ILSVRC2012_val_00000707.JPEG | 764 | rifle | 764 | rifle | True | True | 213.39
708 | ILSVRC2012_val_00000708.JPEG | 214 | Gordon_setter | 214 | Gordon_setter | True | True | 218.72
709 | ILSVRC2012_val_00000709.JPEG | 285 | Egyptian_cat | 285 | Egyptian_cat | True | True | 241.79
710 | ILSVRC2012_val_00000710.JPEG | 641 | maraca | 641 | maraca | True | True | 218.85
711 | ILSVRC2012_val_00000711.JPEG | 951 | lemon | 951 | lemon | True | True | 220.13
712 | ILSVRC2012_val_00000712.JPEG | 882 | vacuum | 882 | vacuum | True | True | 218.09
713 | ILSVRC2012_val_00000713.JPEG | 13 | junco | 13 | junco | True | True | 218.52
714 | ILSVRC2012_val_00000714.JPEG | 829 | streetcar | 829 | streetcar | True | True | 222.35
715 | ILSVRC2012_val_00000715.JPEG | 624 | library | 624 | library | True | True | 214.24
716 | ILSVRC2012_val_00000716.JPEG | 216 | clumber | 216 | clumber | True | True | 218.41
717 | ILSVRC2012_val_00000717.JPEG | 665 | moped | 671 | mountain_bike | False | True | 214.39
718 | ILSVRC2012_val_00000718.JPEG | 521 | Crock_Pot | 521 | Crock_Pot | True | True | 221.53
719 | ILSVRC2012_val_00000719.JPEG | 268 | Mexican_hairless | 268 | Mexican_hairless | True | True | 217.26
720 | ILSVRC2012_val_00000720.JPEG | 468 | cab | 468 | cab | True | True | 221.45
721 | ILSVRC2012_val_00000721.JPEG | 418 | ballpoint | 418 | ballpoint | True | True | 214.38
722 | ILSVRC2012_val_00000722.JPEG | 728 | plastic_bag | 728 | plastic_bag | True | True | 219.52
723 | ILSVRC2012_val_00000723.JPEG | 356 | weasel | 357 | mink | False | True | 214.32
724 | ILSVRC2012_val_00000724.JPEG | 449 | boathouse | 449 | boathouse | True | True | 218.33
725 | ILSVRC2012_val_00000725.JPEG | 194 | Dandie_Dinmont | 194 | Dandie_Dinmont | True | True | 213.01
726 | ILSVRC2012_val_00000726.JPEG | 362 | badger | 362 | badger | True | True | 214.12
727 | ILSVRC2012_val_00000727.JPEG | 948 | Granny_Smith | 948 | Granny_Smith | True | True | 220.99
728 | ILSVRC2012_val_00000728.JPEG | 924 | guacamole | 924 | guacamole | True | True | 220.98
729 | ILSVRC2012_val_00000729.JPEG | 249 | malamute | 248 | Eskimo_dog | False | True | 218.03
730 | ILSVRC2012_val_00000730.JPEG | 524 | cuirass | 524 | cuirass | True | True | 213.34
731 | ILSVRC2012_val_00000731.JPEG | 992 | agaric | 992 | agaric | True | True | 221.27
732 | ILSVRC2012_val_00000732.JPEG | 571 | gas_pump | 571 | gas_pump | True | True | 216.97
733 | ILSVRC2012_val_00000733.JPEG | 283 | Persian_cat | 283 | Persian_cat | True | True | 215.12
734 | ILSVRC2012_val_00000734.JPEG | 608 | jean | 608 | jean | True | True | 214.26
735 | ILSVRC2012_val_00000735.JPEG | 129 | spoonbill | 129 | spoonbill | True | True | 220.61
736 | ILSVRC2012_val_00000736.JPEG | 486 | cello | 486 | cello | True | True | 214.47
737 | ILSVRC2012_val_00000737.JPEG | 859 | toaster | 882 | vacuum | False | True | 221.62
738 | ILSVRC2012_val_00000738.JPEG | 498 | cinema | 498 | cinema | True | True | 217.10
739 | ILSVRC2012_val_00000739.JPEG | 21 | kite | 21 | kite | True | True | 214.15
740 | ILSVRC2012_val_00000740.JPEG | 467 | butcher_shop | 467 | butcher_shop | True | True | 205.37
741 | ILSVRC2012_val_00000741.JPEG | 591 | handkerchief | 591 | handkerchief | True | True | 217.26
742 | ILSVRC2012_val_00000742.JPEG | 924 | guacamole | 924 | guacamole | True | True | 215.14
743 | ILSVRC2012_val_00000743.JPEG | 556 | fire_screen | 790 | shopping_basket | False | True | 217.72
744 | ILSVRC2012_val_00000744.JPEG | 97 | drake | 97 | drake | True | True | 223.09
745 | ILSVRC2012_val_00000745.JPEG | 898 | water_bottle | 898 | water_bottle | True | True | 213.85
746 | ILSVRC2012_val_00000746.JPEG | 586 | half_track | 586 | half_track | True | True | 206.61
747 | ILSVRC2012_val_00000747.JPEG | 10 | brambling | 10 | brambling | True | True | 214.53
748 | ILSVRC2012_val_00000748.JPEG | 202 | soft-coated_wheaten_terrier | 202 | soft-coated_wheaten_terrier | True | True | 221.08
749 | ILSVRC2012_val_00000749.JPEG | 67 | diamondback | 67 | diamondback | True | True | 214.55
750 | ILSVRC2012_val_00000750.JPEG | 501 | cloak | 649 | megalith | False | False | 215.06
751 | ILSVRC2012_val_00000751.JPEG | 141 | redshank | 141 | redshank | True | True | 214.80
752 | ILSVRC2012_val_00000752.JPEG | 603 | horse_cart | 603 | horse_cart | True | True | 219.63
753 | ILSVRC2012_val_00000753.JPEG | 727 | planetarium | 727 | planetarium | True | True | 214.47
754 | ILSVRC2012_val_00000754.JPEG | 101 | tusker | 101 | tusker | True | True | 220.30
755 | ILSVRC2012_val_00000755.JPEG | 995 | earthstar | 995 | earthstar | True | True | 215.63
756 | ILSVRC2012_val_00000756.JPEG | 278 | kit_fox | 278 | kit_fox | True | True | 213.95
757 | ILSVRC2012_val_00000757.JPEG | 964 | potpie | 964 | potpie | True | True | 219.87
758 | ILSVRC2012_val_00000758.JPEG | 240 | Appenzeller | 240 | Appenzeller | True | True | 213.76
759 | ILSVRC2012_val_00000759.JPEG | 423 | barber_chair | 423 | barber_chair | True | True | 217.81
760 | ILSVRC2012_val_00000760.JPEG | 634 | lumbermill | 489 | chainlink_fence | False | False | 214.30
761 | ILSVRC2012_val_00000761.JPEG | 533 | dishrag | 533 | dishrag | True | True | 237.79
762 | ILSVRC2012_val_00000762.JPEG | 424 | barbershop | 423 | barber_chair | False | True | 213.91
763 | ILSVRC2012_val_00000763.JPEG | 451 | bolo_tie | 451 | bolo_tie | True | True | 218.98
764 | ILSVRC2012_val_00000764.JPEG | 555 | fire_engine | 555 | fire_engine | True | True | 217.56
765 | ILSVRC2012_val_00000765.JPEG | 732 | Polaroid_camera | 732 | Polaroid_camera | True | True | 220.56
766 | ILSVRC2012_val_00000766.JPEG | 514 | cowboy_boot | 514 | cowboy_boot | True | True | 214.39
767 | ILSVRC2012_val_00000767.JPEG | 803 | snowplow | 803 | snowplow | True | True | 214.52
768 | ILSVRC2012_val_00000768.JPEG | 300 | tiger_beetle | 305 | dung_beetle | False | True | 215.57
769 | ILSVRC2012_val_00000769.JPEG | 551 | face_powder | 551 | face_powder | True | True | 226.13
770 | ILSVRC2012_val_00000770.JPEG | 753 | radiator | 753 | radiator | True | True | 219.53
771 | ILSVRC2012_val_00000771.JPEG | 411 | apron | 411 | apron | True | True | 213.48
772 | ILSVRC2012_val_00000772.JPEG | 315 | mantis | 315 | mantis | True | True | 214.67
773 | ILSVRC2012_val_00000773.JPEG | 963 | pizza | 963 | pizza | True | True | 214.21
774 | ILSVRC2012_val_00000774.JPEG | 129 | spoonbill | 129 | spoonbill | True | True | 219.54
775 | ILSVRC2012_val_00000775.JPEG | 389 | barracouta | 389 | barracouta | True | True | 214.23
776 | ILSVRC2012_val_00000776.JPEG | 601 | hoopskirt | 819 | stage | False | False | 217.30
777 | ILSVRC2012_val_00000777.JPEG | 526 | desk | 526 | desk | True | True | 215.44
778 | ILSVRC2012_val_00000778.JPEG | 839 | suspension_bridge | 839 | suspension_bridge | True | True | 220.97
779 | ILSVRC2012_val_00000779.JPEG | 299 | meerkat | 299 | meerkat | True | True | 215.65
780 | ILSVRC2012_val_00000780.JPEG | 578 | gown | 578 | gown | True | True | 219.26
781 | ILSVRC2012_val_00000781.JPEG | 112 | conch | 112 | conch | True | True | 216.48
782 | ILSVRC2012_val_00000782.JPEG | 960 | chocolate_sauce | 960 | chocolate_sauce | True | True | 215.27
783 | ILSVRC2012_val_00000783.JPEG | 632 | loudspeaker | 632 | loudspeaker | True | True | 218.50
784 | ILSVRC2012_val_00000784.JPEG | 867 | trailer_truck | 867 | trailer_truck | True | True | 218.08
785 | ILSVRC2012_val_00000785.JPEG | 273 | dingo | 227 | kelpie | False | True | 215.96
786 | ILSVRC2012_val_00000786.JPEG | 61 | boa_constrictor | 61 | boa_constrictor | True | True | 214.38
787 | ILSVRC2012_val_00000787.JPEG | 427 | barrel | 427 | barrel | True | True | 221.63
788 | ILSVRC2012_val_00000788.JPEG | 367 | chimpanzee | 367 | chimpanzee | True | True | 217.59
789 | ILSVRC2012_val_00000789.JPEG | 924 | guacamole | 924 | guacamole | True | True | 219.04
790 | ILSVRC2012_val_00000790.JPEG | 413 | assault_rifle | 413 | assault_rifle | True | True | 214.51
791 | ILSVRC2012_val_00000791.JPEG | 34 | leatherback_turtle | 34 | leatherback_turtle | True | True | 223.47
792 | ILSVRC2012_val_00000792.JPEG | 773 | saltshaker | 773 | saltshaker | True | True | 218.18
793 | ILSVRC2012_val_00000793.JPEG | 654 | minibus | 654 | minibus | True | True | 213.82
794 | ILSVRC2012_val_00000794.JPEG | 131 | little_blue_heron | 131 | little_blue_heron | True | True | 218.22
795 | ILSVRC2012_val_00000795.JPEG | 874 | trolleybus | 874 | trolleybus | True | True | 214.17
796 | ILSVRC2012_val_00000796.JPEG | 282 | tiger_cat | 282 | tiger_cat | True | True | 219.84
797 | ILSVRC2012_val_00000797.JPEG | 891 | waffle_iron | 891 | waffle_iron | True | True | 218.57
798 | ILSVRC2012_val_00000798.JPEG | 956 | custard_apple | 956 | custard_apple | True | True | 228.40
799 | ILSVRC2012_val_00000799.JPEG | 201 | silky_terrier | 187 | Yorkshire_terrier | False | True | 212.61
800 | ILSVRC2012_val_00000800.JPEG | 267 | standard_poodle | 267 | standard_poodle | True | True | 218.47
801 | ILSVRC2012_val_00000801.JPEG | 969 | eggnog | 969 | eggnog | True | True | 212.36
802 | ILSVRC2012_val_00000802.JPEG | 200 | Tibetan_terrier | 200 | Tibetan_terrier | True | True | 214.54
803 | ILSVRC2012_val_00000803.JPEG | 673 | mouse | 673 | mouse | True | True | 213.38
804 | ILSVRC2012_val_00000804.JPEG | 423 | barber_chair | 424 | barbershop | False | True | 218.43
805 | ILSVRC2012_val_00000805.JPEG | 907 | wine_bottle | 907 | wine_bottle | True | True | 212.21
806 | ILSVRC2012_val_00000806.JPEG | 57 | garter_snake | 57 | garter_snake | True | True | 219.65
807 | ILSVRC2012_val_00000807.JPEG | 27 | eft | 27 | eft | True | True | 213.93
808 | ILSVRC2012_val_00000808.JPEG | 459 | brassiere | 459 | brassiere | True | True | 214.68
809 | ILSVRC2012_val_00000809.JPEG | 863 | totem_pole | 863 | totem_pole | True | True | 218.29
810 | ILSVRC2012_val_00000810.JPEG | 322 | ringlet | 322 | ringlet | True | True | 214.68
811 | ILSVRC2012_val_00000811.JPEG | 934 | hotdog | 934 | hotdog | True | True | 215.50
812 | ILSVRC2012_val_00000812.JPEG | 663 | monastery | 663 | monastery | True | True | 232.55
813 | ILSVRC2012_val_00000813.JPEG | 424 | barbershop | 424 | barbershop | True | True | 212.64
814 | ILSVRC2012_val_00000814.JPEG | 687 | organ | 687 | organ | True | True | 214.17
815 | ILSVRC2012_val_00000815.JPEG | 837 | sunglasses | 837 | sunglasses | True | True | 218.69
816 | ILSVRC2012_val_00000816.JPEG | 958 | hay | 958 | hay | True | True | 211.61
817 | ILSVRC2012_val_00000817.JPEG | 645 | maypole | 645 | maypole | True | True | 219.14
818 | ILSVRC2012_val_00000818.JPEG | 120 | fiddler_crab | 119 | rock_crab | False | True | 213.44
819 | ILSVRC2012_val_00000819.JPEG | 306 | rhinoceros_beetle | 306 | rhinoceros_beetle | True | True | 216.06
820 | ILSVRC2012_val_00000820.JPEG | 930 | French_loaf | 930 | French_loaf | True | True | 212.69
821 | ILSVRC2012_val_00000821.JPEG | 121 | king_crab | 121 | king_crab | True | True | 212.67
822 | ILSVRC2012_val_00000822.JPEG | 694 | paddlewheel | 694 | paddlewheel | True | True | 214.40
823 | ILSVRC2012_val_00000823.JPEG | 524 | cuirass | 524 | cuirass | True | True | 212.38
824 | ILSVRC2012_val_00000824.JPEG | 205 | flat-coated_retriever | 205 | flat-coated_retriever | True | True | 218.28
825 | ILSVRC2012_val_00000825.JPEG | 137 | American_coot | 137 | American_coot | True | True | 213.29
826 | ILSVRC2012_val_00000826.JPEG | 849 | teapot | 849 | teapot | True | True | 216.75
827 | ILSVRC2012_val_00000827.JPEG | 681 | notebook | 620 | laptop | False | True | 212.56
828 | ILSVRC2012_val_00000828.JPEG | 380 | titi | 380 | titi | True | True | 214.43
829 | ILSVRC2012_val_00000829.JPEG | 586 | half_track | 586 | half_track | True | True | 212.44
830 | ILSVRC2012_val_00000830.JPEG | 916 | web_site | 916 | web_site | True | True | 218.52
831 | ILSVRC2012_val_00000831.JPEG | 478 | carton | 478 | carton | True | True | 212.37
832 | ILSVRC2012_val_00000832.JPEG | 182 | Border_terrier | 182 | Border_terrier | True | True | 217.66
833 | ILSVRC2012_val_00000833.JPEG | 874 | trolleybus | 874 | trolleybus | True | True | 216.21
834 | ILSVRC2012_val_00000834.JPEG | 715 | pickelhaube | 715 | pickelhaube | True | True | 212.70
835 | ILSVRC2012_val_00000835.JPEG | 590 | hand-held_computer | 487 | cellular_telephone | False | True | 216.99
836 | ILSVRC2012_val_00000836.JPEG | 111 | nematode | 111 | nematode | True | True | 214.15
837 | ILSVRC2012_val_00000837.JPEG | 19 | chickadee | 19 | chickadee | True | True | 213.76
838 | ILSVRC2012_val_00000838.JPEG | 161 | basset | 166 | Walker_hound | False | True | 216.64
839 | ILSVRC2012_val_00000839.JPEG | 915 | yurt | 915 | yurt | True | True | 217.71
840 | ILSVRC2012_val_00000840.JPEG | 730 | plow | 730 | plow | True | True | 209.98
841 | ILSVRC2012_val_00000841.JPEG | 678 | neck_brace | 678 | neck_brace | True | True | 218.93
842 | ILSVRC2012_val_00000842.JPEG | 822 | steel_drum | 822 | steel_drum | True | True | 213.63
843 | ILSVRC2012_val_00000843.JPEG | 818 | spotlight | 818 | spotlight | True | True | 216.97
844 | ILSVRC2012_val_00000844.JPEG | 699 | panpipe | 699 | panpipe | True | True | 213.10
845 | ILSVRC2012_val_00000845.JPEG | 601 | hoopskirt | 601 | hoopskirt | True | True | 212.50
846 | ILSVRC2012_val_00000846.JPEG | 673 | mouse | 673 | mouse | True | True | 214.27
847 | ILSVRC2012_val_00000847.JPEG | 233 | Bouvier_des_Flandres | 233 | Bouvier_des_Flandres | True | True | 217.16
848 | ILSVRC2012_val_00000848.JPEG | 501 | cloak | 406 | altar | False | False | 215.47
849 | ILSVRC2012_val_00000849.JPEG | 624 | library | 624 | library | True | True | 214.80
850 | ILSVRC2012_val_00000850.JPEG | 679 | necklace | 679 | necklace | True | True | 216.81
851 | ILSVRC2012_val_00000851.JPEG | 400 | academic_gown | 400 | academic_gown | True | True | 213.57
852 | ILSVRC2012_val_00000852.JPEG | 581 | grille | 581 | grille | True | True | 218.00
853 | ILSVRC2012_val_00000853.JPEG | 665 | moped | 665 | moped | True | True | 208.69
854 | ILSVRC2012_val_00000854.JPEG | 903 | wig | 903 | wig | True | True | 214.77
855 | ILSVRC2012_val_00000855.JPEG | 622 | lens_cap | 622 | lens_cap | True | True | 212.53
856 | ILSVRC2012_val_00000856.JPEG | 585 | hair_spray | 585 | hair_spray | True | True | 219.49
857 | ILSVRC2012_val_00000857.JPEG | 800 | slot | 800 | slot | True | True | 212.81
858 | ILSVRC2012_val_00000858.JPEG | 899 | water_jug | 899 | water_jug | True | True | 213.59
859 | ILSVRC2012_val_00000859.JPEG | 669 | mosquito_net | 669 | mosquito_net | True | True | 209.71
860 | ILSVRC2012_val_00000860.JPEG | 81 | ptarmigan | 81 | ptarmigan | True | True | 213.58
861 | ILSVRC2012_val_00000861.JPEG | 746 | puck | 746 | puck | True | True | 216.28
862 | ILSVRC2012_val_00000862.JPEG | 595 | harvester | 866 | tractor | False | True | 209.86
863 | ILSVRC2012_val_00000863.JPEG | 935 | mashed_potato | 935 | mashed_potato | True | True | 213.13
864 | ILSVRC2012_val_00000864.JPEG | 668 | mosque | 668 | mosque | True | True | 214.29
865 | ILSVRC2012_val_00000865.JPEG | 295 | American_black_bear | 295 | American_black_bear | True | True | 218.22
866 | ILSVRC2012_val_00000866.JPEG | 893 | wallet | 893 | wallet | True | True | 218.71
867 | ILSVRC2012_val_00000867.JPEG | 266 | miniature_poodle | 265 | toy_poodle | False | True | 213.63
868 | ILSVRC2012_val_00000868.JPEG | 628 | liner | 628 | liner | True | True | 214.02
869 | ILSVRC2012_val_00000869.JPEG | 987 | corn | 923 | plate | False | True | 218.10
870 | ILSVRC2012_val_00000870.JPEG | 367 | chimpanzee | 367 | chimpanzee | True | True | 210.63
871 | ILSVRC2012_val_00000871.JPEG | 294 | brown_bear | 294 | brown_bear | True | True | 214.62
872 | ILSVRC2012_val_00000872.JPEG | 727 | planetarium | 727 | planetarium | True | True | 213.92
873 | ILSVRC2012_val_00000873.JPEG | 12 | house_finch | 12 | house_finch | True | True | 213.77
874 | ILSVRC2012_val_00000874.JPEG | 876 | tub | 876 | tub | True | True | 214.25
875 | ILSVRC2012_val_00000875.JPEG | 186 | Norwich_terrier | 186 | Norwich_terrier | True | True | 216.15
876 | ILSVRC2012_val_00000876.JPEG | 589 | hand_blower | 589 | hand_blower | True | True | 212.36
877 | ILSVRC2012_val_00000877.JPEG | 70 | harvestman | 70 | harvestman | True | True | 213.88
878 | ILSVRC2012_val_00000878.JPEG | 129 | spoonbill | 129 | spoonbill | True | True | 218.27
879 | ILSVRC2012_val_00000879.JPEG | 454 | bookshop | 454 | bookshop | True | True | 212.37
880 | ILSVRC2012_val_00000880.JPEG | 17 | jay | 17 | jay | True | True | 214.56
881 | ILSVRC2012_val_00000881.JPEG | 946 | cardoon | 946 | cardoon | True | True | 210.16
882 | ILSVRC2012_val_00000882.JPEG | 200 | Tibetan_terrier | 200 | Tibetan_terrier | True | True | 217.72
883 | ILSVRC2012_val_00000883.JPEG | 181 | Bedlington_terrier | 181 | Bedlington_terrier | True | True | 212.86
884 | ILSVRC2012_val_00000884.JPEG | 163 | bloodhound | 163 | bloodhound | True | True | 214.84
885 | ILSVRC2012_val_00000885.JPEG | 80 | black_grouse | 80 | black_grouse | True | True | 214.00
886 | ILSVRC2012_val_00000886.JPEG | 940 | spaghetti_squash | 940 | spaghetti_squash | True | True | 213.47
887 | ILSVRC2012_val_00000887.JPEG | 587 | hammer | 558 | flute | False | True | 214.87
888 | ILSVRC2012_val_00000888.JPEG | 21 | kite | 21 | kite | True | True | 213.51
889 | ILSVRC2012_val_00000889.JPEG | 198 | standard_schnauzer | 198 | standard_schnauzer | True | True | 213.82
890 | ILSVRC2012_val_00000890.JPEG | 25 | European_fire_salamander | 25 | European_fire_salamander | True | True | 228.90
891 | ILSVRC2012_val_00000891.JPEG | 932 | pretzel | 932 | pretzel | True | True | 214.15
892 | ILSVRC2012_val_00000892.JPEG | 339 | sorrel | 339 | sorrel | True | True | 218.88
893 | ILSVRC2012_val_00000893.JPEG | 480 | cash_machine | 480 | cash_machine | True | True | 211.45
894 | ILSVRC2012_val_00000894.JPEG | 764 | rifle | 764 | rifle | True | True | 212.96
895 | ILSVRC2012_val_00000895.JPEG | 883 | vase | 883 | vase | True | True | 218.57
896 | ILSVRC2012_val_00000896.JPEG | 454 | bookshop | 454 | bookshop | True | True | 213.30
897 | ILSVRC2012_val_00000897.JPEG | 807 | solar_dish | 807 | solar_dish | True | True | 213.94
898 | ILSVRC2012_val_00000898.JPEG | 287 | lynx | 287 | lynx | True | True | 214.16
899 | ILSVRC2012_val_00000899.JPEG | 868 | tray | 868 | tray | True | True | 220.94
900 | ILSVRC2012_val_00000900.JPEG | 614 | kimono | 614 | kimono | True | True | 209.96
901 | ILSVRC2012_val_00000901.JPEG | 814 | speedboat | 625 | lifeboat | False | True | 217.94
902 | ILSVRC2012_val_00000902.JPEG | 591 | handkerchief | 591 | handkerchief | True | True | 213.62
903 | ILSVRC2012_val_00000903.JPEG | 919 | street_sign | 919 | street_sign | True | True | 214.20
904 | ILSVRC2012_val_00000904.JPEG | 508 | computer_keyboard | 508 | computer_keyboard | True | True | 216.04
905 | ILSVRC2012_val_00000905.JPEG | 479 | car_wheel | 479 | car_wheel | True | True | 213.06
906 | ILSVRC2012_val_00000906.JPEG | 452 | bonnet | 452 | bonnet | True | True | 213.28
907 | ILSVRC2012_val_00000907.JPEG | 155 | Shih-Tzu | 155 | Shih-Tzu | True | True | 213.73
908 | ILSVRC2012_val_00000908.JPEG | 41 | whiptail | 41 | whiptail | True | True | 218.24
909 | ILSVRC2012_val_00000909.JPEG | 163 | bloodhound | 163 | bloodhound | True | True | 216.01
910 | ILSVRC2012_val_00000910.JPEG | 606 | iron | 606 | iron | True | True | 216.35
911 | ILSVRC2012_val_00000911.JPEG | 7 | cock | 8 | hen | False | True | 210.86
912 | ILSVRC2012_val_00000912.JPEG | 269 | timber_wolf | 269 | timber_wolf | True | True | 213.20
913 | ILSVRC2012_val_00000913.JPEG | 576 | gondola | 576 | gondola | True | True | 218.37
914 | ILSVRC2012_val_00000914.JPEG | 858 | tile_roof | 698 | palace | False | True | 212.78
915 | ILSVRC2012_val_00000915.JPEG | 506 | coil | 506 | coil | True | True | 229.25
916 | ILSVRC2012_val_00000916.JPEG | 23 | vulture | 23 | vulture | True | True | 211.99
917 | ILSVRC2012_val_00000917.JPEG | 447 | binoculars | 447 | binoculars | True | True | 223.45
918 | ILSVRC2012_val_00000918.JPEG | 397 | puffer | 397 | puffer | True | True | 222.88
919 | ILSVRC2012_val_00000919.JPEG | 595 | harvester | 595 | harvester | True | True | 217.42
920 | ILSVRC2012_val_00000920.JPEG | 753 | radiator | 753 | radiator | True | True | 215.99
921 | ILSVRC2012_val_00000921.JPEG | 5 | electric_ray | 5 | electric_ray | True | True | 228.54
922 | ILSVRC2012_val_00000922.JPEG | 186 | Norwich_terrier | 186 | Norwich_terrier | True | True | 222.33
923 | ILSVRC2012_val_00000923.JPEG | 667 | mortarboard | 667 | mortarboard | True | True | 221.33
924 | ILSVRC2012_val_00000924.JPEG | 305 | dung_beetle | 305 | dung_beetle | True | True | 216.67
925 | ILSVRC2012_val_00000925.JPEG | 46 | green_lizard | 46 | green_lizard | True | True | 222.57
926 | ILSVRC2012_val_00000926.JPEG | 303 | long-horned_beetle | 303 | long-horned_beetle | True | True | 216.10
927 | ILSVRC2012_val_00000927.JPEG | 673 | mouse | 673 | mouse | True | True | 222.44
928 | ILSVRC2012_val_00000928.JPEG | 927 | trifle | 927 | trifle | True | True | 213.83
929 | ILSVRC2012_val_00000929.JPEG | 91 | coucal | 91 | coucal | True | True | 214.33
930 | ILSVRC2012_val_00000930.JPEG | 34 | leatherback_turtle | 34 | leatherback_turtle | True | True | 218.34
931 | ILSVRC2012_val_00000931.JPEG | 757 | recreational_vehicle | 757 | recreational_vehicle | True | True | 216.71
932 | ILSVRC2012_val_00000932.JPEG | 406 | altar | 406 | altar | True | True | 217.50
933 | ILSVRC2012_val_00000933.JPEG | 390 | eel | 65 | sea_snake | False | True | 214.00
934 | ILSVRC2012_val_00000934.JPEG | 76 | tarantula | 76 | tarantula | True | True | 219.03
935 | ILSVRC2012_val_00000935.JPEG | 517 | crane | 517 | crane | True | True | 215.67
936 | ILSVRC2012_val_00000936.JPEG | 806 | sock | 806 | sock | True | True | 220.75
937 | ILSVRC2012_val_00000937.JPEG | 330 | wood_rabbit | 331 | hare | False | True | 219.26
938 | ILSVRC2012_val_00000938.JPEG | 34 | leatherback_turtle | 34 | leatherback_turtle | True | True | 221.63
939 | ILSVRC2012_val_00000939.JPEG | 130 | flamingo | 130 | flamingo | True | True | 211.78
940 | ILSVRC2012_val_00000940.JPEG | 103 | platypus | 103 | platypus | True | True | 215.41
941 | ILSVRC2012_val_00000941.JPEG | 56 | king_snake | 56 | king_snake | True | True | 214.45
942 | ILSVRC2012_val_00000942.JPEG | 545 | electric_fan | 545 | electric_fan | True | True | 229.70
943 | ILSVRC2012_val_00000943.JPEG | 78 | tick | 78 | tick | True | True | 223.80
944 | ILSVRC2012_val_00000944.JPEG | 31 | tree_frog | 31 | tree_frog | True | True | 219.13
945 | ILSVRC2012_val_00000945.JPEG | 372 | baboon | 372 | baboon | True | True | 211.78
946 | ILSVRC2012_val_00000946.JPEG | 235 | German_shepherd | 235 | German_shepherd | True | True | 214.12
947 | ILSVRC2012_val_00000947.JPEG | 516 | cradle | 516 | cradle | True | True | 219.57
948 | ILSVRC2012_val_00000948.JPEG | 159 | Rhodesian_ridgeback | 159 | Rhodesian_ridgeback | True | True | 215.28
949 | ILSVRC2012_val_00000949.JPEG | 187 | Yorkshire_terrier | 187 | Yorkshire_terrier | True | True | 214.82
950 | ILSVRC2012_val_00000950.JPEG | 930 | French_loaf | 930 | French_loaf | True | True | 216.95
951 | ILSVRC2012_val_00000951.JPEG | 888 | viaduct | 888 | viaduct | True | True | 227.22
952 | ILSVRC2012_val_00000952.JPEG | 96 | toucan | 96 | toucan | True | True | 211.22
953 | ILSVRC2012_val_00000953.JPEG | 444 | bicycle-built-for-two | 665 | moped | False | False | 217.59
954 | ILSVRC2012_val_00000954.JPEG | 991 | coral_fungus | 991 | coral_fungus | True | True | 214.46
955 | ILSVRC2012_val_00000955.JPEG | 872 | tripod | 622 | lens_cap | False | True | 214.09
956 | ILSVRC2012_val_00000956.JPEG | 302 | ground_beetle | 302 | ground_beetle | True | True | 214.65
957 | ILSVRC2012_val_00000957.JPEG | 566 | French_horn | 566 | French_horn | True | True | 213.23
958 | ILSVRC2012_val_00000958.JPEG | 33 | loggerhead | 33 | loggerhead | True | True | 215.41
959 | ILSVRC2012_val_00000959.JPEG | 818 | spotlight | 619 | lampshade | False | True | 213.41
960 | ILSVRC2012_val_00000960.JPEG | 694 | paddlewheel | 694 | paddlewheel | True | True | 219.23
961 | ILSVRC2012_val_00000961.JPEG | 406 | altar | 406 | altar | True | True | 209.70
962 | ILSVRC2012_val_00000962.JPEG | 20 | water_ouzel | 20 | water_ouzel | True | True | 219.55
963 | ILSVRC2012_val_00000963.JPEG | 18 | magpie | 18 | magpie | True | True | 210.99
964 | ILSVRC2012_val_00000964.JPEG | 371 | patas | 371 | patas | True | True | 219.11
965 | ILSVRC2012_val_00000965.JPEG | 320 | damselfly | 320 | damselfly | True | True | 214.20
966 | ILSVRC2012_val_00000966.JPEG | 724 | pirate | 780 | schooner | False | True | 214.57
967 | ILSVRC2012_val_00000967.JPEG | 994 | stinkhorn | 996 | hen-of-the-woods | False | True | 214.68
968 | ILSVRC2012_val_00000968.JPEG | 730 | plow | 730 | plow | True | True | 213.89
969 | ILSVRC2012_val_00000969.JPEG | 613 | joystick | 613 | joystick | True | True | 213.41
970 | ILSVRC2012_val_00000970.JPEG | 105 | koala | 105 | koala | True | True | 216.92
971 | ILSVRC2012_val_00000971.JPEG | 878 | typewriter_keyboard | 878 | typewriter_keyboard | True | True | 214.77
972 | ILSVRC2012_val_00000972.JPEG | 311 | grasshopper | 311 | grasshopper | True | True | 214.14
973 | ILSVRC2012_val_00000973.JPEG | 883 | vase | 883 | vase | True | True | 216.24
974 | ILSVRC2012_val_00000974.JPEG | 367 | chimpanzee | 367 | chimpanzee | True | True | 212.59
975 | ILSVRC2012_val_00000975.JPEG | 243 | bull_mastiff | 243 | bull_mastiff | True | True | 214.68
976 | ILSVRC2012_val_00000976.JPEG | 627 | limousine | 627 | limousine | True | True | 216.69
977 | ILSVRC2012_val_00000977.JPEG | 944 | artichoke | 944 | artichoke | True | True | 219.46
978 | ILSVRC2012_val_00000978.JPEG | 43 | frilled_lizard | 43 | frilled_lizard | True | True | 216.73
979 | ILSVRC2012_val_00000979.JPEG | 412 | ashcan | 412 | ashcan | True | True | 217.59
980 | ILSVRC2012_val_00000980.JPEG | 921 | book_jacket | 921 | book_jacket | True | True | 214.14
981 | ILSVRC2012_val_00000981.JPEG | 332 | Angora | 332 | Angora | True | True | 214.33
982 | ILSVRC2012_val_00000982.JPEG | 474 | cardigan | 608 | jean | False | False | 235.68
983 | ILSVRC2012_val_00000983.JPEG | 276 | hyena | 276 | hyena | True | True | 225.15
984 | ILSVRC2012_val_00000984.JPEG | 629 | lipstick | 629 | lipstick | True | True | 219.07
985 | ILSVRC2012_val_00000985.JPEG | 917 | comic_book | 917 | comic_book | True | True | 225.18
986 | ILSVRC2012_val_00000986.JPEG | 77 | wolf_spider | 77 | wolf_spider | True | True | 233.59
987 | ILSVRC2012_val_00000987.JPEG | 643 | mask | 723 | pinwheel | False | True | 219.32
988 | ILSVRC2012_val_00000988.JPEG | 556 | fire_screen | 556 | fire_screen | True | True | 225.86
989 | ILSVRC2012_val_00000989.JPEG | 998 | ear | 998 | ear | True | True | 219.24
990 | ILSVRC2012_val_00000990.JPEG | 328 | sea_urchin | 328 | sea_urchin | True | True | 224.73
991 | ILSVRC2012_val_00000991.JPEG | 723 | pinwheel | 723 | pinwheel | True | True | 219.72
992 | ILSVRC2012_val_00000992.JPEG | 161 | basset | 161 | basset | True | True | 220.21
993 | ILSVRC2012_val_00000993.JPEG | 250 | Siberian_husky | 250 | Siberian_husky | True | True | 220.34
994 | ILSVRC2012_val_00000994.JPEG | 1 | goldfish | 1 | goldfish | True | True | 237.53
995 | ILSVRC2012_val_00000995.JPEG | 919 | street_sign | 919 | street_sign | True | True | 218.62
996 | ILSVRC2012_val_00000996.JPEG | 392 | rock_beauty | 392 | rock_beauty | True | True | 223.42
997 | ILSVRC2012_val_00000997.JPEG | 264 | Cardigan | 264 | Cardigan | True | True | 219.16
998 | ILSVRC2012_val_00000998.JPEG | 408 | amphibian | 408 | amphibian | True | True | 207.89
999 | ILSVRC2012_val_00000999.JPEG | 633 | loupe | 512 | corkscrew | False | False | 222.42
1000 | ILSVRC2012_val_00001000.JPEG | 495 | china_cabinet | 495 | china_cabinet | True | True | 220.14
