qohwxv/Transformer/ILSVRC2012_dataset_test/m8_results_current_labeled.csv

ordinal | dataset_index | source_image | source_image_sha256 | prepared_input_sha256 | gt_synset_id | gt_wnid | expected_class_index | expected_class_label | predicted_class_index | predicted_class_label | top1_correct | class_logit | class_probability | job_cycles | inference_elapsed_ms | commands | status_final | error_code | error_info | status | result_record
1 | 1 | datasets/ILSVRC2012_img_val/ILSVRC2012_val_00000001.JPEG | e31b2caf5d202426e9918522a38b81e473c5cdc31086e6d640c89f594d1c32f9 | adffd16038f51c7c869435f699b17ae84803cc9ca59bf0e52130eae93d98d9da | 490 | n01751748 | 65 | sea snake | 65 | sea snake | PASS | 0x4166A8BA | 0x3F7C0AF3 | 22529734040 | 450741 | 249 | 0x00000015 | 0x00000000 | 0x00000000 | PASS | build/m8_dataset_runs/20260811T124853Z-m8-mode1000/image_01/m8_image_result.txt
2 | 2 | datasets/ILSVRC2012_img_val/ILSVRC2012_val_00000002.JPEG | 8c765c2ed1563774e8d778e10787de2b548c2c217c938b35f9c5a68f035efced | 7e04d394b61dd171ca5e4a3151f59751fb91a73090dc75e711464d5978764cb8 | 361 | n09193705 | 970 | alp | 795 | ski | FAIL | 0x413AE5D8 | 0x3F3FC2FB | 22529462781 | 450758 | 249 | 0x00000015 | 0x00000000 | 0x00000000 | PASS | build/m8_dataset_runs/20260811T124853Z-m8-mode1000/image_02/m8_image_result.txt
3 | 3 | datasets/ILSVRC2012_img_val/ILSVRC2012_val_00000003.JPEG | 5c4cb0feea216245694b4b3cbea22439478988483f2ca2a1b4c43b22131e8289 | 821e2795e6aa10a0e3a1739726dc9c563a0abb1409a87f41a691e5cdea5040f3 | 171 | n02105855 | 230 | Shetland sheepdog, Shetland sheep dog, Shetland | 230 | Shetland sheepdog, Shetland sheep dog, Shetland | PASS | 0x41572ED6 | 0x3F619E0D | 22528695680 | 450771 | 249 | 0x00000015 | 0x00000000 | 0x00000000 | PASS | build/m8_dataset_runs/20260811T124853Z-m8-mode1000/image_03/m8_image_result.txt
4 | 4 | datasets/ILSVRC2012_img_val/ILSVRC2012_val_00000004.JPEG | 3f8e0ffd4fbfba751cca6c774e877366b9ff6e3e580c0078ff1f345d4c4ecffb | b0b90646a1ff1304e2e6089930ede5ebcb3f8b9d7d80c6c7433f7b03fa856aa3 | 822 | n04263257 | 809 | soup bowl | 925 | consomme | FAIL | 0x41351484 | 0x3EF952B8 | 22530161649 | 450833 | 249 | 0x00000015 | 0x00000000 | 0x00000000 | PASS | build/m8_dataset_runs/20260811T124853Z-m8-mode1000/image_04/m8_image_result.txt
5 | 5 | datasets/ILSVRC2012_img_val/ILSVRC2012_val_00000005.JPEG | 49dcb3a26f024566150937b922a1bf6523d070cf42835dbbf9930c8e9c7824ea | 1a8e327431628d263cda652060cc838aec74eec2cf976b37a75cdb5349a21f33 | 297 | n03125729 | 516 | cradle | 516 | cradle | PASS | 0x413A0758 | 0x3F3C37BB | 22529017505 | 450792 | 249 | 0x00000015 | 0x00000000 | 0x00000000 | PASS | build/m8_dataset_runs/20260811T124853Z-m8-mode1000/image_05/m8_image_result.txt
6 | 6 | datasets/ILSVRC2012_img_val/ILSVRC2012_val_00000006.JPEG | d17ed0beb1e8e3a29b6382d3b609b8c04f35a6cea9c8c535f92cdd6c49da31c8 | 17cb4bbeb5501d59665df5a5b7b34735ff0069bacfe7007caf855bc1788a6324 | 482 | n01735189 | 57 | garter snake, grass snake | 57 | garter snake, grass snake | PASS | 0x412C2DEE | 0x3EC50789 | 22529522958 | 450683 | 249 | 0x00000015 | 0x00000000 | 0x00000000 | PASS | build/m8_dataset_runs/20260811T124853Z-m8-mode1000/image_06/m8_image_result.txt
7 | 7 | datasets/ILSVRC2012_img_val/ILSVRC2012_val_00000007.JPEG | 4ce8af9006c3b578e81222046f9fecef87e6f20af3b6c0517ba758aa5118923c | cb9f692cda63c48e051e068bc68ec933260bd43262f14820a6074995fa002267 | 13 | n02346627 | 334 | porcupine, hedgehog | 334 | porcupine, hedgehog | PASS | 0x41700C63 | 0x3F7FC298 | 22529480327 | 450640 | 249 | 0x00000015 | 0x00000000 | 0x00000000 | PASS | build/m8_dataset_runs/20260811T124853Z-m8-mode1000/image_07/m8_image_result.txt
8 | 8 | datasets/ILSVRC2012_img_val/ILSVRC2012_val_00000008.JPEG | a02a03cb1749b679a7fdb22e464bf027ed647ada937da8857d573120cbdc710e | 3e1eaaf1b5bafb1f72e17f2b0d27612258d36830116186122a5d5835960e9403 | 704 | n02776631 | 415 | bakery, bakeshop, bakehouse | 415 | bakery, bakeshop, bakehouse | PASS | 0x410F7DCF | 0x3F0AC30C | 22530129959 | 450833 | 249 | 0x00000015 | 0x00000000 | 0x00000000 | PASS | build/m8_dataset_runs/20260811T124853Z-m8-mode1000/image_08/m8_image_result.txt
9 | 9 | datasets/ILSVRC2012_img_val/ILSVRC2012_val_00000009.JPEG | 668f3c5b5a74a4f9b84dbe317375d60c521634acd237dd4061379838aa00bff0 | 998fde25a651bcb37d927525c49765cf827538f5827abbb2e15eb1e5834ce39e | 599 | n03794056 | 674 | mousetrap | 674 | mousetrap | PASS | 0x4160E3AB | 0x3F7FA470 | 22529263638 | 450850 | 249 | 0x00000015 | 0x00000000 | 0x00000000 | PASS | build/m8_dataset_runs/20260811T124853Z-m8-mode1000/image_09/m8_image_result.txt
10 | 10 | datasets/ILSVRC2012_img_val/ILSVRC2012_val_00000010.JPEG | e0fef05b81a4230de09320ff70d46ccc16984bf2dfb23a4abadde970b605cf2f | 3eca7672cbe74f218697c1ad5322f9531cec806b11fa96a5c6c484e4d6d54b2a | 164 | n02328150 | 332 | Angora, Angora rabbit | 204 | Lhasa, Lhasa apso | FAIL | 0x40FF4406 | 0x3E7C04FE | 22530609274 | 450808 | 249 | 0x00000015 | 0x00000000 | 0x00000000 | PASS | build/m8_dataset_runs/20260811T124853Z-m8-mode1000/image_10/m8_image_result.txt
11 | 11 | datasets/ILSVRC2012_img_val/ILSVRC2012_val_00000011.JPEG | 70e8db18be134292365ca34065ea2ace9af3fa192ac5bf9d0ca1f9276785eb33 | 9b29ec2ebdfa0b911149ed9c09bf11dd24f8a3687b732906a7a4d951c4868083 | 649 | n01917289 | 109 | brain coral | 109 | brain coral | PASS | 0x41682926 | 0x3F777845 | 22529501845 | 450783 | 249 | 0x00000015 | 0x00000000 | 0x00000000 | PASS | build/m8_dataset_runs/20260811T124853Z-m8-mode1000/image_11/m8_image_result.txt
12 | 12 | datasets/ILSVRC2012_img_val/ILSVRC2012_val_00000012.JPEG | 7317f9c63185aca84d8c76dab0607d3a39248e25b610d016f6c63b6fe81f8156 | 75f7212f23c14947b80bf17f41dc3cd07d6cbfb6a63f96db357a61c1ad5b80cf | 11 | n02125311 | 286 | cougar, puma, catamount, mountain lion, painter, panther, Felis concolor | 286 | cougar, puma, catamount, mountain lion, painter, panther, Felis concolor | PASS | 0x4172B8E6 | 0x3F7F8561 | 22528936508 | 450777 | 249 | 0x00000015 | 0x00000000 | 0x00000000 | PASS | build/m8_dataset_runs/20260811T124853Z-m8-mode1000/image_12/m8_image_result.txt
13 | 13 | datasets/ILSVRC2012_img_val/ILSVRC2012_val_00000013.JPEG | bd39f358d1e6725f1a29129b129dfd9b2be17a3e18bc3a66bb4ccc13a88075b3 | 47c21bb4201be89a69620a321c0a2b4aacdf7cf7c482c39dc11ca3f96bf99801 | 73 | n02484975 | 370 | guenon, guenon monkey | 370 | guenon, guenon monkey | PASS | 0x4177DCDE | 0x3F7E4077 | 22527490920 | 450797 | 249 | 0x00000015 | 0x00000000 | 0x00000000 | PASS | build/m8_dataset_runs/20260811T124853Z-m8-mode1000/image_13/m8_image_result.txt
14 | 14 | datasets/ILSVRC2012_img_val/ILSVRC2012_val_00000014.JPEG | 3898d81fa0345b9f308106198c69b1d1d44ea8d20d67e9ff141186ea92aadf9b | 8cd83fbb8d7e431c50df0685b7aea186004c6eeea019b74db8f7433f4b8fc27a | 286 | n04065272 | 757 | recreational vehicle, RV, R.V. | 757 | recreational vehicle, RV, R.V. | PASS | 0x413FB139 | 0x3F696151 | 22528515013 | 450647 | 249 | 0x00000015 | 0x00000000 | 0x00000000 | PASS | build/m8_dataset_runs/20260811T124853Z-m8-mode1000/image_14/m8_image_result.txt
15 | 15 | datasets/ILSVRC2012_img_val/ILSVRC2012_val_00000015.JPEG | 6e90b2f9cfa7de3ca71028b4c8edaf814a0cb72b77860e976c9a8bcec6d10c33 | 87a1509efa9f02f2e749877c3b700dac074b7ee494a71057934636009e4219a0 | 554 | n03496892 | 595 | harvester, reaper | 595 | harvester, reaper | PASS | 0x412A9C93 | 0x3F42432C | 22529131975 | 450604 | 249 | 0x00000015 | 0x00000000 | 0x00000000 | PASS | build/m8_dataset_runs/20260811T124853Z-m8-mode1000/image_15/m8_image_result.txt
16 | 16 | datasets/ILSVRC2012_img_val/ILSVRC2012_val_00000016.JPEG | 2ba30967738cd67cac594bac2e82bd1b3fe51a36741118134249a17843196aad | 27cd16b30d4ee263bfde839387551da7132d24dde2ffa98d2cb2f098bad091d3 | 6 | n02066245 | 147 | grey whale, gray whale, devilfish, Eschrichtius gibbosus, Eschrichtius robustus | 147 | grey whale, gray whale, devilfish, Eschrichtius gibbosus, Eschrichtius robustus | PASS | 0x41627CC0 | 0x3F7FAECB | 22528440013 | 450758 | 249 | 0x00000015 | 0x00000000 | 0x00000000 | PASS | build/m8_dataset_runs/20260811T124853Z-m8-mode1000/image_16/m8_image_result.txt
17 | 17 | datasets/ILSVRC2012_img_val/ILSVRC2012_val_00000017.JPEG | bd1b52bb35bdaa7f1b92f980ebdf216c79f568d8410f59e4c8770e700bfe1eef | aa13b93d1ef8d90f05bdb8b5d6c6c97dcd8e8f8d165134385f451f365f6865dd | 648 | n01914609 | 108 | sea anemone, anemone | 327 | starfish, sea star | FAIL | 0x4146F40C | 0x3F589922 | 22529599502 | 450763 | 249 | 0x00000015 | 0x00000000 | 0x00000000 | PASS | build/m8_dataset_runs/20260811T124853Z-m8-mode1000/image_17/m8_image_result.txt
18 | 18 | datasets/ILSVRC2012_img_val/ILSVRC2012_val_00000018.JPEG | 031d4be7016f117883605305d65a2e752ace0b0124e6b199a88432685195b80f | 8d279b3141c2e49cc99b3beee82cdec8e2330ddd81235815689f024e6ec9768d | 399 | n01616318 | 23 | vulture | 23 | vulture | PASS | 0x413A044A | 0x3F08B949 | 22530705649 | 450826 | 249 | 0x00000015 | 0x00000000 | 0x00000000 | PASS | build/m8_dataset_runs/20260811T124853Z-m8-mode1000/image_18/m8_image_result.txt
19 | 19 | datasets/ILSVRC2012_img_val/ILSVRC2012_val_00000019.JPEG | 10017431e7ec8fe4718dd0ea747818f99a0b3ee55931602ab72d031f0cf80b6b | 465fb2105170a3c68b87b47f8a60200e4db402cf120298c06ad2a47fa1f01cd2 | 749 | n02971356 | 478 | carton | 478 | carton | PASS | 0x41480BAE | 0x3F6C12DD | 22530037529 | 450793 | 249 | 0x00000015 | 0x00000000 | 0x00000000 | PASS | build/m8_dataset_runs/20260811T124853Z-m8-mode1000/image_19/m8_image_result.txt
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
89 | 89 | datasets/ILSVRC2012_img_val/ILSVRC2012_val_00000089.JPEG | 22ced55ee61a665a3b51c7b27700f876f0636b655a54bf442dabe6c799feaf0c | 2d9fc9277df315324a5a1b43ddde133b8985b6cef43f77ebd60c62ea4587f639 | 914 | n02992529 | 487 | cellular telephone, cellular phone, cellphone, cell, mobile phone | 487 | cellular telephone, cellular phone, cellphone, cell, mobile phone | PASS | 0x415DDE63 | 0x3F7E07CD | 22528425633 | 450799 | 249 | 0x00000015 | 0x00000000 | 0x00000000 | PASS | build/m8_dataset_runs/20260811T124853Z-m8-mode1000/image_89/m8_image_result.txt
90 | 90 | datasets/ILSVRC2012_img_val/ILSVRC2012_val_00000090.JPEG | 53371716b65b0c2f0db248ad8f8398d32186449d173e13688082f375311a4fe3 | e150768ad665d42be6224b8886f9a15a69b7e860f39949d8b96bcab6c74e380f | 476 | n01698640 | 50 | American alligator, Alligator mississipiensis | 50 | American alligator, Alligator mississipiensis | PASS | 0x415A7C8E | 0x3F7E367B | 22527835898 | 450744 | 249 | 0x00000015 | 0x00000000 | 0x00000000 | PASS | build/m8_dataset_runs/20260811T124853Z-m8-mode1000/image_90/m8_image_result.txt
91 | 91 | datasets/ILSVRC2012_img_val/ILSVRC2012_val_00000091.JPEG | 3cd9af05ad6dd1cb511a9ca1076b026a7449b406448aa01c2f7583e94821198c | b2599bd6c61cfc2e1a7a69f017fc010e1e78717ecf0e8a0253957db0baf359f6 | 102 | n02114548 | 270 | white wolf, Arctic wolf, Canis lupus tundrarum | 270 | white wolf, Arctic wolf, Canis lupus tundrarum | PASS | 0x4158B18E | 0x3F792AFD | 22529225788 | 450797 | 249 | 0x00000015 | 0x00000000 | 0x00000000 | PASS | build/m8_dataset_runs/20260811T124853Z-m8-mode1000/image_91/m8_image_result.txt
92 | 92 | datasets/ILSVRC2012_img_val/ILSVRC2012_val_00000092.JPEG | ea620cb663eab4dda08631d31633d2f870a69fc08b5da7051dd50d252baebdd1 | 22b5c7cc98a75c625134cedb5372702645bd746125755405437088805c283cdc | 199 | n02497673 | 383 | Madagascar cat, ring-tailed lemur, Lemur catta | 383 | Madagascar cat, ring-tailed lemur, Lemur catta | PASS | 0x41519DF4 | 0x3F0C1E16 | 22530131855 | 450712 | 249 | 0x00000015 | 0x00000000 | 0x00000000 | PASS | build/m8_dataset_runs/20260811T124853Z-m8-mode1000/image_92/m8_image_result.txt
93 | 93 | datasets/ILSVRC2012_img_val/ILSVRC2012_val_00000093.JPEG | f0a67bc3f52041d4102d5ba0d588189551939aa72cccd3b41ee8512478ee5e13 | 5dc4bdfc6c611006ae7fb95d17521b4e103f84e5d0e84c357ebe78c3cd4a385a | 104 | n02480855 | 366 | gorilla, Gorilla gorilla | 366 | gorilla, Gorilla gorilla | PASS | 0x413A239C | 0x3F677876 | 22529208709 | 450684 | 249 | 0x00000015 | 0x00000000 | 0x00000000 | PASS | build/m8_dataset_runs/20260811T124853Z-m8-mode1000/image_93/m8_image_result.txt
94 | 94 | datasets/ILSVRC2012_img_val/ILSVRC2012_val_00000094.JPEG | cbfff0c8f3b274203f260e90736693bd7298ddd547220eec8b14707d95dd6091 | d808dd433c36f3df6ab352619614c0d98000bb8fe25c4f079421a7a6be21c250 | 221 | n04147183 | 780 | schooner | 484 | catamaran | FAIL | 0x414484CF | 0x3F5B64C7 | 22529587716 | 450728 | 249 | 0x00000015 | 0x00000000 | 0x00000000 | PASS | build/m8_dataset_runs/20260811T124853Z-m8-mode1000/image_94/m8_image_result.txt
95 | 95 | datasets/ILSVRC2012_img_val/ILSVRC2012_val_00000095.JPEG | d26e4887a7ba687a7e3c8e3d819253a490e8a20c2cdd2ab7468ce13a3d970615 | 8409f5ed387cb3bc21a387be3be35a4c4e6f04b9457d0f2f88133c81d4884b71 | 138 | n02487347 | 373 | macaque | 373 | macaque | PASS | 0x414F21F9 | 0x3F7350C9 | 22528198579 | 450641 | 249 | 0x00000015 | 0x00000000 | 0x00000000 | PASS | build/m8_dataset_runs/20260811T124853Z-m8-mode1000/image_95/m8_image_result.txt
96 | 96 | datasets/ILSVRC2012_img_val/ILSVRC2012_val_00000096.JPEG | add88c668ee7add774d2e75821e414e90286078ed087bf9827d76764ee4bb73d | 0e9d51a1f69396d035b2bf36306a38a00887343c76c1d9e74035e3751e9d3a43 | 257 | n03895866 | 705 | passenger car, coach, carriage | 705 | passenger car, coach, carriage | PASS | 0x4157A9AF | 0x3F7B0EA4 | 22529281885 | 450714 | 249 | 0x00000015 | 0x00000000 | 0x00000000 | PASS | build/m8_dataset_runs/20260811T124853Z-m8-mode1000/image_96/m8_image_result.txt
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
189 | 189 | datasets/ILSVRC2012_img_val/ILSVRC2012_val_00000189.JPEG | 7b2513ef495dd9d43539a603cd13f10388ac2cc36ce4241a07074935ab034e0c | c9ba7fc1d7b616b67b0b7b3200c99f31f6b22ab37ec050be241eb4e72489e99d | 217 | n01873310 | 103 | platypus, duckbill, duckbilled platypus, duck-billed platypus, Ornithorhynchus anatinus | 103 | platypus, duckbill, duckbilled platypus, duck-billed platypus, Ornithorhynchus anatinus | PASS | 0x415E2915 | 0x3F7D2499 | 22530639181 | 450902 | 249 | 0x00000015 | 0x00000000 | 0x00000000 | PASS | build/m8_dataset_runs/20260811T124853Z-m8-mode1000/image_189/m8_image_result.txt
190 | 190 | datasets/ILSVRC2012_img_val/ILSVRC2012_val_00000190.JPEG | 08e0c89dd3feeff5e0e9edd2fc667987a578a74afc582865071f51695eeac061 | 9e9fe32a55a2c33f6b51ea79939de6d586fa787588bf915acf6508fe85f57fbd | 581 | n03476684 | 584 | hair slide | 584 | hair slide | PASS | 0x41446130 | 0x3F79FE90 | 22530317667 | 450661 | 249 | 0x00000015 | 0x00000000 | 0x00000000 | PASS | build/m8_dataset_runs/20260811T124853Z-m8-mode1000/image_190/m8_image_result.txt
191 | 191 | datasets/ILSVRC2012_img_val/ILSVRC2012_val_00000191.JPEG | 4865806f49481ee15ddae02a8dc93cafe7baa7d94bf8c766223f41027bd281e5 | b242347b7abd45d0a8709aa66838e273504a89dc85f271124f320d7c0ad50cbd | 170 | n02093428 | 180 | American Staffordshire terrier, Staffordshire terrier, American pit bull terrier, pit bull terrier | 180 | American Staffordshire terrier, Staffordshire terrier, American pit bull terrier, pit bull terrier | PASS | 0x414C8665 | 0x3F34B339 | 22528498289 | 450656 | 249 | 0x00000015 | 0x00000000 | 0x00000000 | PASS | build/m8_dataset_runs/20260811T124853Z-m8-mode1000/image_191/m8_image_result.txt
192 | 192 | datasets/ILSVRC2012_img_val/ILSVRC2012_val_00000192.JPEG | 4af73446678cfb28f92df8ef42f1980e820e3eb208bc32fa0a28e706e429f833 | 677ad802ffa20f066ab61f27151679dbc6ac2c3e5ce714ac96e60009c57d634f | 306 | n03891251 | 703 | park bench | 703 | park bench | PASS | 0x41273E75 | 0x3F5C6747 | 22530117279 | 450653 | 249 | 0x00000015 | 0x00000000 | 0x00000000 | PASS | build/m8_dataset_runs/20260811T124853Z-m8-mode1000/image_192/m8_image_result.txt
193 | 193 | datasets/ILSVRC2012_img_val/ILSVRC2012_val_00000193.JPEG | 336ddf7c9669db3168918f96c943d2756f5748821d2db8182366da832f8d0b17 | 04e7381890a12e0120c4a0de47b2654db3719124dc9df3899cbee46b29869a4d | 689 | n02859443 | 449 | boathouse | 449 | boathouse | PASS | 0x411B9C92 | 0x3E8E55C0 | 22531496882 | 450880 | 249 | 0x00000015 | 0x00000000 | 0x00000000 | PASS | build/m8_dataset_runs/20260811T124853Z-m8-mode1000/image_193/m8_image_result.txt
194 | 194 | datasets/ILSVRC2012_img_val/ILSVRC2012_val_00000194.JPEG | 7f6ee4db96c233863a899b7e1cd69ad466cfd702588848f9fcb543ff7e29f2bc | fa97e31d7099285614e5d99922288be8793b54d865c5b8f4f0874d09430c548b | 753 | n04125021 | 771 | safe | 771 | safe | PASS | 0x416002AD | 0x3F7F1656 | 22529546590 | 450679 | 249 | 0x00000015 | 0x00000000 | 0x00000000 | PASS | build/m8_dataset_runs/20260811T124853Z-m8-mode1000/image_194/m8_image_result.txt
195 | 195 | datasets/ILSVRC2012_img_val/ILSVRC2012_val_00000195.JPEG | 1cee914ef685fc7010a8406a6d9897dae65f0d3c783b8cdb2ded2c710b90888d | 89b9de5b04900199b9763404cd1af5b82b2f890d431950e4d9e73b1269452245 | 613 | n01978287 | 118 | Dungeness crab, Cancer magister | 118 | Dungeness crab, Cancer magister | PASS | 0x411FEDAD | 0x3ED5B853 | 22528017963 | 450593 | 249 | 0x00000015 | 0x00000000 | 0x00000000 | PASS | build/m8_dataset_runs/20260811T124853Z-m8-mode1000/image_195/m8_image_result.txt
196 | 196 | datasets/ILSVRC2012_img_val/ILSVRC2012_val_00000196.JPEG | f82a81c628c918670b13b6596a3c67c98fc713cd8678eccc0e66c845926fbe6e | 3c1332eac9611dcda9ce379ddf33f2a43b5a8b17cfcf8d742225eedac443018f | 454 | n02643566 | 396 | lionfish | 396 | lionfish | PASS | 0x4163E322 | 0x3F7F3E35 | 22528249457 | 450684 | 249 | 0x00000015 | 0x00000000 | 0x00000000 | PASS | build/m8_dataset_runs/20260811T124853Z-m8-mode1000/image_196/m8_image_result.txt
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
