qohwxv/Transformer/01_SOURCE_CODE_DAY_DU/immutable/full_vivado_receipt/remote_snapshot/reports/m8/server_runs/20260808T161943Z-m8-softmax-ooc-ab-holdfix/LOCAL_INITIAL_FAILURE_SHA256SUMS.txt

e217074da4d12b2b2dd7c7d1fa9251b05e7e39eb66cb0a14b130cb4d866b3072  ./FAILURE_PAYLOAD_SHA256SUMS.txt
e5e3d5f2de49de24abd4238398f1585ba4fb68b0738c1a6436e2d6666e3df5ef  ./INPUT_PATHS.txt
0f72b7bf296a3472614e9b4e2311747ea48d9e9d403780eb00878fdfbffa1386  ./INPUT_SHA256SUMS.txt
b5ec554dc2b5d35e79242592937c9028988d706e9261686f33b504696d53a852  ./REMOTE_RUNNER.log
e99c22e8c43721cc561f373aa649396d945a698259dca7b538d5929df721e7f3  ./RUN_LAUNCH.txt
221b32f46dcdd6e5afbfa20fb0ef48d955cb3bcb639e3c82809c10923dab8b54  ./input_snapshot/PARENT_M7S8_PROVENANCE.txt
9ddbb13b65f53be82a3bde83f572e1124fe9333b557582b7f60d2d8b8d7b1ec9  ./input_snapshot/rtl/blocks/softmax/vit_softmax_engine_fp32.sv
4b40d6e0b1992fabe0eca28cdbc1cb2956c4085b3410e9bba2d80290e8795d8e  ./input_snapshot/rtl/leaf/common/vit_u32_mul_iterative_nodsp.sv
3721a6d130e655c524c642513bf5920d32c0a75a3abb88e0378ed7b5c2352141  ./input_snapshot/rtl/leaf/fp32/vit_fp32_add_comb.sv
bb5bc2bcbd3340a86621503b94f648a6d2419635795c9360f94423a12e931af7  ./input_snapshot/rtl/leaf/fp32/vit_fp32_compare.sv
a585625170dda40ee7b72118c58e09ee38fd7fca8f33a86a9abeff21bef11b96  ./input_snapshot/rtl/leaf/fp32/vit_fp32_from_u32_comb.sv
8652521edca10e731633fbe62850b77dc9dc2ad9b52bff1312ef5842bae83c3a  ./input_snapshot/rtl/leaf/fp32/vit_fp32_mul_comb_nodsp.sv
3f65527a52361b1dae5312e809215f9eb8e84de93337282b66a54567f0ba6678  ./input_snapshot/rtl/leaf/fp32/vit_fp32_scale_pow2_down_comb.sv
58db5df211dcf9f60d7d5d7c4779e6ec5044e47d537e279d385ceb8bae57a821  ./input_snapshot/rtl/leaf/fp32/vit_fp32_to_u32_floor_comb.sv
078f614b3625e9e7d7889fea82bf3388913cd3fb90cffb72b08324e11350a0f7  ./input_snapshot/rtl/pkg/vit_fp32_pkg.sv
4613263dd791c1d1a2e00a9ce6001b5c7ebc5ce36882c33bbd6aef06de5593da  ./input_snapshot/sim/m8/reference/vit_softmax_engine_fp32_parent_v1_12.sv
d54ca828aa6cdd20fdbfb999f08d295889e25177d6aec4452d2783f1cea85869  ./input_snapshot/sim/m8/run_softmax_ooc_ab.sh
58c98b85913e0d1fa16025af84834c67619d928fcc897bfad9492e2fabfea07e  ./input_snapshot/sim/softmax/run_softmax_buffer_ooc.tcl
b5ec554dc2b5d35e79242592937c9028988d706e9261686f33b504696d53a852  ./parent.console.log
73e7b822618e9fbb26af91b956e74e0fd43f0919b02e6ccd1c0e607f144c95fd  ./parent/artifacts/post_synth.dcp
1ba7021711ad383e2891b43319ccc1aabd874f70712616e100315d2e9458b5f8  ./parent/reports/post_route_loops.rpt
c3f5806b9195a55782acc476eec7288d42e37c7022e1cf93c94fbb278b5dc22c  ./parent/reports/post_route_status.rpt
f7b6348ab97db6954e20688706fc4de4026f22ad28ff7d152cc46bde8a0ddeb1  ./parent/reports/post_route_structure.rpt
c0eea3f484eab4b788dfa215f72f62a700a0e90e3f61fa7e13dd7a1ab5ff11e4  ./parent/reports/post_route_timing_gate.rpt
11c7fd2ce20a3e91b7e9e641dc2cf85b41bf5250cc0fe865e7ce6f11d4cd6ddf  ./parent/reports/post_route_timing_summary.rpt
7233132e95286700fee0b7b04085bae1b640f92ae38b00368443f0401e34bf37  ./parent/reports/post_route_utilization.rpt
921db0240388bd29fa648e6d95a4148c11977e8b9763d854af20798e34c62e52  ./parent/reports/post_synth_loops.rpt
f35f93ded2905d41b6f318029ed68415338bac94536a771b83c153ee170cdbaf  ./parent/reports/post_synth_structure.rpt
f41534a29fae55848b4b5ddfc2b08d03670c8bfec015619edbd8e6365c81e7e1  ./parent/reports/post_synth_timing_summary.rpt
43775f7d3ceed831009fbf8754892cc9b95eb1ec1994adebd27c20343013f138  ./parent/reports/post_synth_utilization.rpt
1bede09ab65273500f346cc766ac9f66cf8382b90552597c8dc2678d21fe78cf  ./parent/source.sha256
