qohwxv/Transformer/01_SOURCE_CODE_DAY_DU/immutable/full_vivado_receipt/remote_snapshot/reports/m8/server_runs/20260808T173000Z-m8-e04-mode3-pass-repeat-receipt/EXPECTED_CONTEXT_FAILURE.txt

EXPECTED_NON_DUT_FAILURE run=20260808T173100Z-m8-e04-mode3-observation
stage=asset_staging
rtl_compile_started=NO
rtl_simulation_started=NO
reason=cannot_discover_workspace_root_from_asset_module_path
asset_stage_log_sha256=46f3c381ed5499a91dc0a59325b3c4c500d2a7038a1fd07521340bf969461580
outer_log_sha256=3c03570e2253f3911e6aa91f38fe58d763caa94ce7baa3218f255129307e227f
exact_failure_marker=M7_MODE3_ASSET_STAGE_FAIL reason=cannot discover workspace root from module path /home/s23520579/Vivado_project/vit_m8_db4e84bbe7b2_workspace/vivado_server_307_perf_v1_m8_nongemm_nodsp_2023_2/sim/end_to_end/m7_mode3_real_assets.py
exact_terminal_marker=FAIL: package-v3 E04 asset staging failed
classification=HARNESS_WORKSPACE_CONTEXT_FAILURE_NOT_DUT_FAILURE
