qohwxv/Transformer/01_SOURCE_CODE_DAY_DU/immutable/full_vivado_receipt/remote_snapshot/reports/m8/server_runs/20260808T164100Z-m8-layernorm-ooc-ab-generate-fix/corrected_full_pass/remote_run/candidate/SUMMARY.txt

RESULT=PASS
SCOPE=STANDALONE_M8_LAYERNORM_BUFFER_OOC
VIVADO=2023.2
PART=xczu5ev-sfvc784-1-e
CLOCK_PERIOD_NS=20.000
BUFFER_ENABLE=1
ROW_AFFINE_BUFFER_DEPTH=1024
POST_SYNTH_RAMB36=3
POST_ROUTE_RAMB36=3
POST_ROUTE_RAMB18=0
POST_ROUTE_URAM=0
POST_ROUTE_LUTRAM=0
POST_ROUTE_DSP48_DSP58=0
BLACKBOX=0
LATCH=0
COMBINATIONAL_LOOPS=0
WNS_NS=10.964
WHS_NS=0.019
ROUTABLE_NETS=1983
FULLY_ROUTED_NETS=1983
ROUTING_ERRORS=0
EXPLICIT_OOC_GAPS=1
DRC_SEVERE=0
METHODOLOGY_SEVERE=0
FULL_CHIP_TIMING_SIGNOFF=0
CAVEAT=OOC boundary hold is false-pathed; integration must repeat full-device timing
