qohwxv/Transformer/(commit log)

2026-08-11 Implement file audit script in README
    Add script for auditing declared and current files.
2026-08-26 Add M8 memory frontend POC baseline and regression
    [baseline_summary.csv]
2026-08-28 Complete M8 memory frontend M2 M3 and M7 optimizations
    [optimized_summary.csv]
